greenenergyprojects/electro-vehicle-wallbox-station/evws1/kicad/dist/evws1_image-bottom.jpg

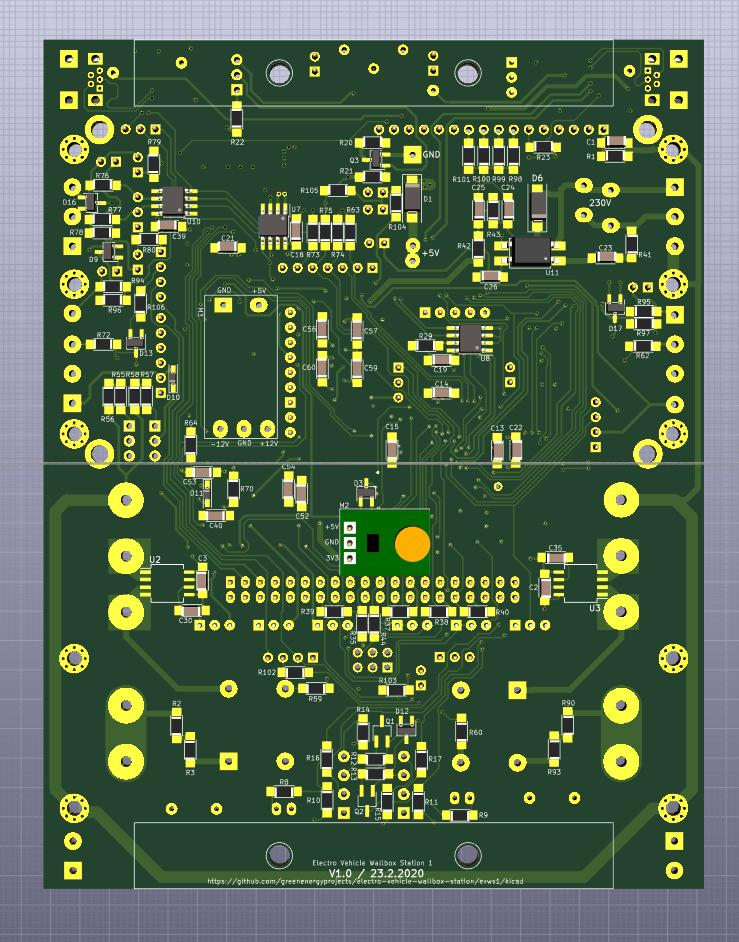
evws1/kicad/dist/evws1_image-bottom.jpg
