greenenergyprojects/electro-vehicle-wallbox-station/evws1/kicad/dist/evws1_image-top.jpg

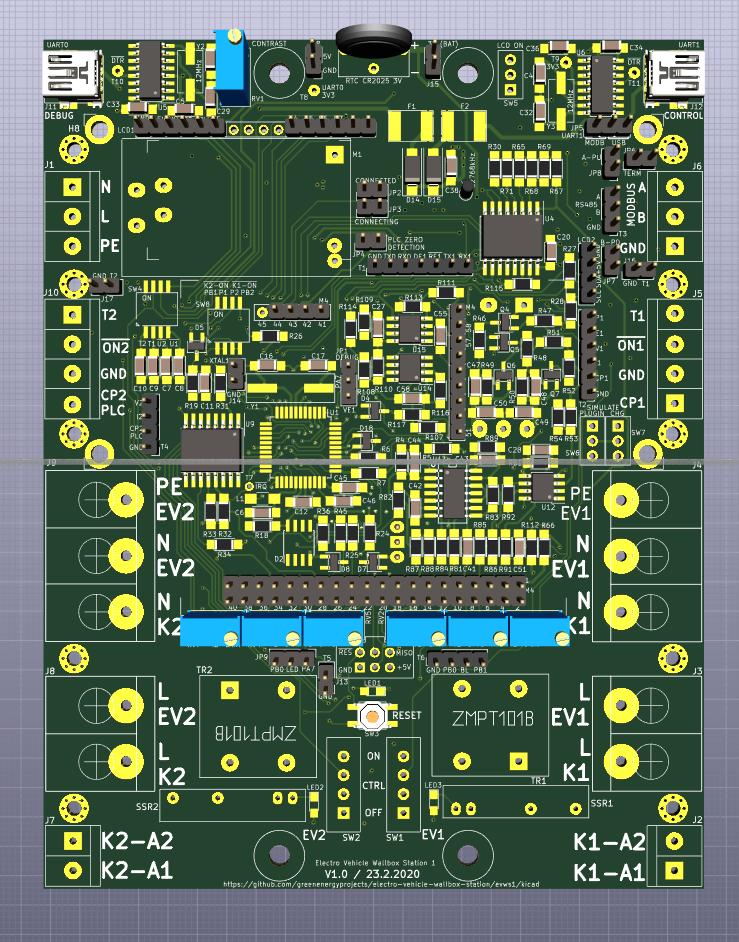
evws1/kicad/dist/evws1_image-top.jpg
