greenenergyprojects/electro-vehicle-wallbox-station/README.md

# electro-vehicle-wallbox-station
Electro Vehicle Wallbox, Mode 3 / Typ 2 (230V/AC/20A)
