greenenergyprojects/electro-vehicle-wallbox-station/evws1/kicad/dist/README.md

# Manufacturing report

## Gerber Files

See [https://support.jlcpcb.com/article/44-how-to-export-kicad-pcb-to-gerber-files](https://support.jlcpcb.com/article/44-how-to-export-kicad-pcb-to-gerber-files)

## Manufacturing details

* Tapeout: 23.2.2020
  [https://jlcpcb.com/client/index.html#/order](https://jlcpcb.com/client/index.html#/order)
  Order Number: Y11-2360571A (5 pcs, €62,95 EUR)

# Bugs / Improvements

Mechanical Drawings from Layer NP to PHT(PLATING Through Hole) (email request from support@jlcpcb.com on 2018-09-21)

| Reference | Description |
| --- | --- |
