greenenergyprojects/electro-vehicle-wallbox-station/evws1/kicad/dist/evws1_bom.ods

Source: | /work/sx/gep/electro-vehicle-wallbox-station/evws1/kicad/evws1.sch
Date: | So 23 Feb 2020 16:09:32 CET
Tool: | Eeschema 5.0.2-bee76a0~70~ubuntu18.04.1
Component Count: | 302
Ref | Value | Footprint | Datasheet | Manufacturer | Vendor
BT1 | 3V | Project:knob-battery-holder-vertical-tht | ~
C1 | 1n | Project:c-1206-hand-soldering | ~
C2 | 100n | Project:c-1206-hand-soldering | ~
C3 | 100n | Project:c-1206-hand-soldering | ~
C4 | 22p | Project:c-1206-hand-soldering | ~
C5 | 100n | Project:c-1206-hand-soldering | ~
C6 | 100n | Project:c-1206-hand-soldering | ~
C7 | 100n | Project:c-1206-hand-soldering | ~
C8 | 100n | Project:c-1206-hand-soldering | ~
C9 | 100n | Project:c-1206-hand-soldering | ~
C10 | 100n | Project:c-1206-hand-soldering | ~
C11 | 1n | Project:c-1206-hand-soldering | ~
C12 | 100n | Project:c-1206-hand-soldering | ~
C13 | 100n | Project:c-1206-hand-soldering | ~
C14 | 100n | Project:c-1206-hand-soldering | ~
C15 | 100n | Project:c-1206-hand-soldering | ~
C16 | 22p | Project:c-1206-hand-soldering | ~
C17 | 22p | Project:c-1206-hand-soldering | ~
C18 | 100n | Project:c-1206-hand-soldering | ~
C19 | 100n | Project:c-1206-hand-soldering | ~
C20 | 100n | Project:c-1206-hand-soldering | ~
C21 | 100n | Project:c-1206-hand-soldering | ~
C22 | 100n | Project:c-1206-hand-soldering | ~
C23 | 2.2n | Project:c-1206-hand-soldering | ~
C24 | 220n | Project:c-1206-hand-soldering | ~
C25 | 1u | Project:c-1206-hand-soldering | ~
C26 | 1n | Project:c-1206-hand-soldering | ~
C27 | 1pF | Project:c-1206-hand-soldering | ~
C28 | 1u | Project:c-1206-hand-soldering
C29 | 22p | Project:c-1206-hand-soldering | ~
C30 | 1n | Project:c-1206-hand-soldering | ~
C31 | 22p | Project:c-1206-hand-soldering | ~
C32 | 22p | Project:c-1206-hand-soldering | ~
C33 | 100n | Project:c-1206-hand-soldering | ~
C34 | 100n | Project:c-1206-hand-soldering | ~
C35 | 1n | Project:c-1206-hand-soldering | ~
C36 | 100n | Project:c-1206-hand-soldering | ~
C38 | 100n | Project:c-1206-hand-soldering | ~
C39 | 100n | Project:c-1206-hand-soldering | ~
C40 | 100n | Project:c-1206-hand-soldering | ~
C41 | 10n | Project:c-1206-hand-soldering | ~
C42 | 10n | Project:c-1206-hand-soldering | ~
C43 | 10n | Project:c-1206-hand-soldering | ~
C44 | 10n | Project:c-1206-hand-soldering | ~
C45 | 1n | Project:c-1206-hand-soldering | ~
C46 | 1n | Project:c-1206-hand-soldering | ~
C47 | 1n | Project:c-1206-hand-soldering | ~
C48 | 1n | Project:c-1206-hand-soldering | ~
C49 | 1u | Project:c-1206-hand-soldering | ~
C50 | 1u | Project:c-1206-hand-soldering | ~
C51 | 100n | Project:c-1206-hand-soldering | ~
C52 | 100n | Project:c-1206-hand-soldering | ~
C53 | 100n | Project:c-1206-hand-soldering | ~
C54 | 100n | Project:c-1206-hand-soldering | ~
C55 | 1pF | Project:c-1206-hand-soldering | ~
C56 | 100n | Project:c-1206-hand-soldering | ~
C57 | 100n | Project:c-1206-hand-soldering | ~
C58 | 1u | Project:c-1206-hand-soldering | ~
C59 | 100n | Project:c-1206-hand-soldering | ~
C60 | 100n | Project:c-1206-hand-soldering | ~
D1 | SS34 | Project:sma_hand-soldering | ~
D2 | LM285M-2.5 | Project:SOIC-8_3.9x4.9mm_Pitch1.27mm_Handsolded
D3 | BAT54S | Project:sot-23_hand-soldering
D4 | BAT54S | Project:sot-23_hand-soldering
D5 | BAT54S | Project:sot-23_hand-soldering
D6 | 1N4007 | Project:sma_hand-soldering | ~
D7 | BAT54S | Project:sot-23_hand-soldering
D8 | BAT54S | Project:sot-23_hand-soldering
D9 | BAT54S | Project:sot-23_hand-soldering
D10 | B5819WS | Project:sod-323_hand-soldering
D11 | B5819WS | Project:sod-323_hand-soldering
D12 | BAT54S | Project:sot-23_hand-soldering
D13 | BAT54S | Project:sot-23_hand-soldering
D14 | SS34 | Project:sma_hand-soldering
D15 | SS34 | Project:sma_hand-soldering
D16 | SM712 | Project:sot-23_hand-soldering
D17 | BAT54S | Project:sot-23_hand-soldering
D18 | BAT54S | Project:sot-23_hand-soldering
F1 | MF-SMDF050-2 | Project:mf-smdf | ~
F2 | MF-SMDF050-2 | Project:mf-smdf | ~
H1 | DIN-Rail-Adapter-DRG02 | Project:DIN-RAIL-ADAPTER-DRG-02-ebay-254055322883 | ~
H2 | DIN-Rail-Adapter-DRG02 | Project:DIN-RAIL-ADAPTER-DRG-02-ebay-254055322883 | ~
H3 | MountingHole_Pad | Mounting_Holes:MountingHole_2.5mm_Pad_Via | ~
H4 | MountingHole_Pad | Mounting_Holes:MountingHole_2.5mm_Pad_Via | ~
H5 | MountingHole_Pad | Mounting_Holes:MountingHole_2.5mm_Pad_Via | ~
H6 | MountingHole_Pad | Mounting_Holes:MountingHole_2.5mm_Pad_Via | ~
H7 | MountingHole_Pad | Mounting_Holes:MountingHole_2.5mm_Pad_Via | ~
H8 | MountingHole_Pad | Mounting_Holes:MountingHole_2.5mm_Pad_Via | ~
H9 | MountingHole_Pad | Mounting_Holes:MountingHole_2.5mm_Pad_Via | ~
H10 | MountingHole_Pad | Mounting_Holes:MountingHole_2.5mm_Pad_Via | ~
H11 | MountingHole_Pad | Mounting_Holes:MountingHole_2.5mm_Pad_Via | ~
H12 | MountingHole_Pad | Mounting_Holes:MountingHole_2.5mm_Pad_Via | ~
J1 | Screw_Terminal_01x03 | Project:Terminalblock-5mm-3P | ~
J2 | Screw_Terminal_01x02 | Project:Terminalblock-5mm-2P | ~
J3 | HB9500-2P | Project:HB9500-2P
J4 | HB9500-3P | Project:HB9500-3P
J5 | Screw_Terminal_01x04 | Project:Terminalblock-5mm-4P | ~
J6 | Screw_Terminal_01x03 | Project:Terminalblock-5mm-3P | ~
J7 | Screw_Terminal_01x02 | Project:Terminalblock-5mm-2P | ~
J8 | HB9500-2P | Project:HB9500-2P
J9 | HB9500-3P | Project:HB9500-3P
J10 | Screw_Terminal_01x04 | Project:Terminalblock-5mm-4P | ~
J11 | USB 2.0 Mini | Project:usb-mini-tht
J12 | USB 2.0 Mini | Project:usb-mini-tht
J13 | atmega-isp-6 | Project:AVR-ISP-6
J14 | header | Project:idc-header-1x02-p2.54mm-vertical | ~
J15 | header | Project:idc-header-1x02-p2.54mm-vertical | ~
J16 | header | Project:idc-header-1x02-p2.54mm-vertical | ~
J17 | header | Project:idc-header-1x02-p2.54mm-vertical | ~
J18 | header | Project:idc-header-1x02-p2.54mm-vertical | ~
JP1 | Jumper_3_Bridged12 | Project:idc-header-1x03-p2.54mm-vertical | ~
JP2 | header | Project:idc-header-1x02-p2.54mm-vertical | ~
JP3 | header | Project:idc-header-1x02-p2.54mm-vertical | ~
JP4 | Jumper_NO_Small | Project:idc-header-1x02-p2.54mm-vertical | ~
JP5 | Jumper | Project:idc-header-1x03-p2.54mm-vertical | ~
JP6 | header | Project:idc-header-1x02-p2.54mm-vertical | ~
JP7 | header | Project:idc-header-1x02-p2.54mm-vertical | ~
JP8 | header | Project:idc-header-1x02-p2.54mm-vertical | ~
JP9 | header | Project:idc-header-1x03-p2.54mm-vertical | ~
L1 | 10uH | Inductors_SMD:L_1206_HandSoldering | ~
LCD1 | lcd-4x20-5v-backlight-4bit | Project:lcd-4x20-5v-backlight-4bit
LCD2 | header | Project:idc-header-1x04-p2.54mm-vertical | ~
LED1 | LED | LEDs:LED_0805_HandSoldering | ~
LED2 | LED | LEDs:LED_0805_HandSoldering | ~
LED3 | LED | LEDs:LED_0805_HandSoldering | ~
M1 | HLK-PM01 | Project:HLK-PM01-5M05
M2 | dc-dc-buck-converter-5v-to-3.3v-2a | Project:dc-dc-buck-converter-5v-to-3.3v-2a
M3 | dc-dc-converter-5v-to-p12v-m12v | Project:dc-dc-converter-5v-to-p12v-m12v
M4 | rpi-ev-plc-adapter-v1.0 | Project:rpi-ev-plc-adapter-v1.0
Q1 | AO3401 | TO_SOT_Packages_SMD:TSOT-23_HandSoldering | ~
Q2 | AO3401 | TO_SOT_Packages_SMD:TSOT-23_HandSoldering | ~
Q3 | AO3400 | Project:sot-23_hand-soldering
Q4 | AO3400 | Project:sot-23_hand-soldering
Q5 | AO3401 | Project:sot-23_hand-soldering | ~
Q6 | AO3401 | Project:sot-23_hand-soldering | ~
Q7 | AO3400 | Project:sot-23_hand-soldering
R1 | 0R | Project:r-1206-hand-soldering | ~
R2 | 390K | Project:r-1206-hand-soldering | ~
R3 | 390K | Project:r-1206-hand-soldering | ~
R4 | 10K | Project:r-1206-hand-soldering | ~
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
R98 | 47K | Project:r-1206-hand-soldering | ~
R99 | 47K | Project:r-1206-hand-soldering | ~
R100 | 47K | Project:r-1206-hand-soldering | ~
R101 | 47K | Project:r-1206-hand-soldering | ~
R102 | 220R | Project:r-1206-hand-soldering | ~
R103 | 1K | Project:r-1206-hand-soldering | ~
R104 | 270R | Project:r-1206-hand-soldering | ~
R105 | 560R | Project:r-1206-hand-soldering | ~
R106 | 0R | Project:r-1206-hand-soldering | ~
R107 | 1K | Project:r-1206-hand-soldering | ~
R108 | 10K | Project:r-1206-hand-soldering | ~
R109 | 0R | Project:r-1206-hand-soldering | ~
R110 | 0R | Project:r-1206-hand-soldering | ~
R111 | 0R | Project:r-1206-hand-soldering | ~
R112 | 0R | Project:r-1206-hand-soldering | ~
R113 | 10K | Project:r-1206-hand-soldering | ~
R114 | 10K | Project:r-1206-hand-soldering | ~
R115 | 10K | Project:r-1206-hand-soldering | ~
R116 | 470K | Project:r-1206-hand-soldering | ~
R117 | 1K | Project:r-1206-hand-soldering | ~
RV1 | 10K | Project:trimmer-tht-3296 | ~
RV2 | 100R | Project:trimmer-tht-3296 | ~
RV3 | 1K | Project:trimmer-tht-3296 | ~
RV4 | 100R | Project:trimmer-tht-3296 | ~
RV5 | 1K | Project:trimmer-tht-3296 | ~
RV6 | 1K | Project:trimmer-tht-3296 | ~
RV7 | 1K | Project:trimmer-tht-3296 | ~
SSR1 | G3MB-202P | Project:SSR_Omron_G3MB-202P
SSR2 | G3MB-202P | Project:SSR_Omron_G3MB-202P
SW1 | SW_SS13F06-G5 | Project:Switch-3pos-SS13F06-G5
SW2 | SW_SS13F06-G5 | Project:Switch-3pos-SS13F06-G5
SW3 | SW_Push | Project:push-button-smd-4.5x4.5mm-black
SW4 | dip-switch-4x2pos-smd-1.27mm | Project:dip-switch-4x2pos-smd-1.27mm
SW5 | SS-12D00G3 | Project:switch_ss-12d00g3
SW6 | SS-12D00G3 | Project:switch_ss-12d00g3
SW7 | SS-12D00G3 | Project:switch_ss-12d00g3
SW8 | dip-switch-4x2pos-smd-1.27mm | Project:dip-switch-4x2pos-smd-1.27mm
T1 | header | Project:idc-header-1x07-p2.54mm-vertical | ~
T2 | header | Project:idc-header-1x06-p2.54mm-vertical | ~
T3 | header | Project:idc-header-1x03-p2.54mm-vertical | ~
T4 | header | Project:idc-header-1x04-p2.54mm-vertical | ~
T5 | header | Project:idc-header-1x02-p2.54mm-vertical | ~
T6 | header | Project:idc-header-1x04-p2.54mm-vertical | ~
T7 | TestPoint | Measurement_Points:Measurement_Point_Round-TH_Small | ~
T8 | TestPoint | Wire_Pads:SolderWirePad_single_0-8mmDrill | ~
T9 | TestPoint | Wire_Pads:SolderWirePad_single_0-8mmDrill | ~
T10 | TestPoint | Wire_Pads:SolderWirePad_single_0-8mmDrill | ~
T11 | TestPoint | Wire_Pads:SolderWirePad_single_0-8mmDrill | ~
TR1 | ZMPT101B | Project:Transformer-zmpt101b_ebay-121438904988
TR2 | ZMPT101B | Project:Transformer-zmpt101b_ebay-121438904988
U1 | atmega324p-20au | Project:TQFP-44_10x10mm_Pitch0.8mm
U2 | ACS712-30 | Project:ACS712
U3 | ACS712-30 | Project:ACS712
U4 | PCF8591 | Project:soic-16w_hand-soldering
U5 | ch340g | Project:soic-16_hand-soldering
U6 | ch340g | Project:soic-16_hand-soldering
U7 | DS1307ZN | Project:soic-8_hand-soldering
U8 | 24LC512 | Project:soic-8_hand-soldering
U9 | PCF8574 | Project:soic-16w_hand-soldering
U10 | max485esa | Project:soic-8_hand-soldering
U11 | PC817C | Project:sop-4-pc817
U12 | LM258 | Project:soic-8_hand-soldering
U13 | LM224 | Project:soic-14_hand-soldering
U14 | LM258 | Project:soic-8_hand-soldering
U15 | AD633AR | Project:soic-8_hand-soldering
Y1 | 20MHz | Project:hc49s-smd | ~
Y2 | 12MHz | Project:Oscillator-SMD-M49S | ~
Y3 | 12MHz | Project:Oscillator-SMD-M49S | ~
Y4 | 32768kHz | Project:crystal-32.768khz-2x6mm-tht-vertical | ~
