greenenergyprojects/electro-vehicle-wallbox-station/evws1/kicad/dist/evws1_schematic-bw.pdf

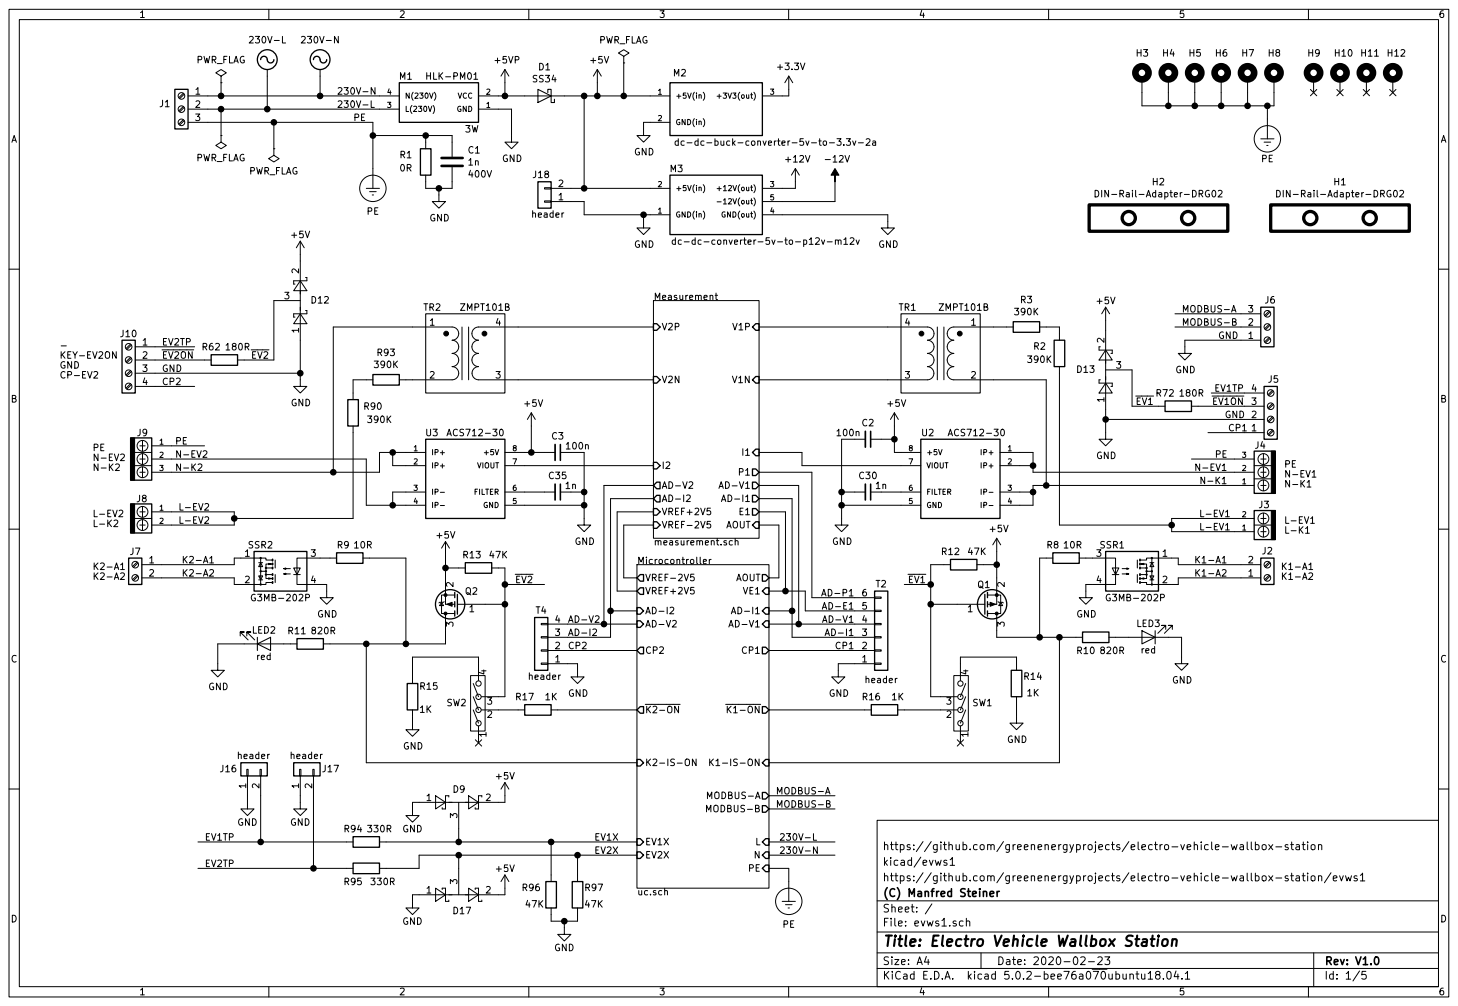
[picture p3: page 1]

2 | 230V-L
3 | PE

dc-dc-buck-converter-5v-to-3.3v-2a GND

https://github.com/greenenergyprojects/electro-vehicle-wallbox-station
kicad/evws1
https://github.com/greenenergyprojects/electro-vehicle-wallbox-station/evws1
File: evws1.sch Sheet: / (C) Manfred Steiner

Id: 1/5 Title: Electro Vehicle Wallbox Station

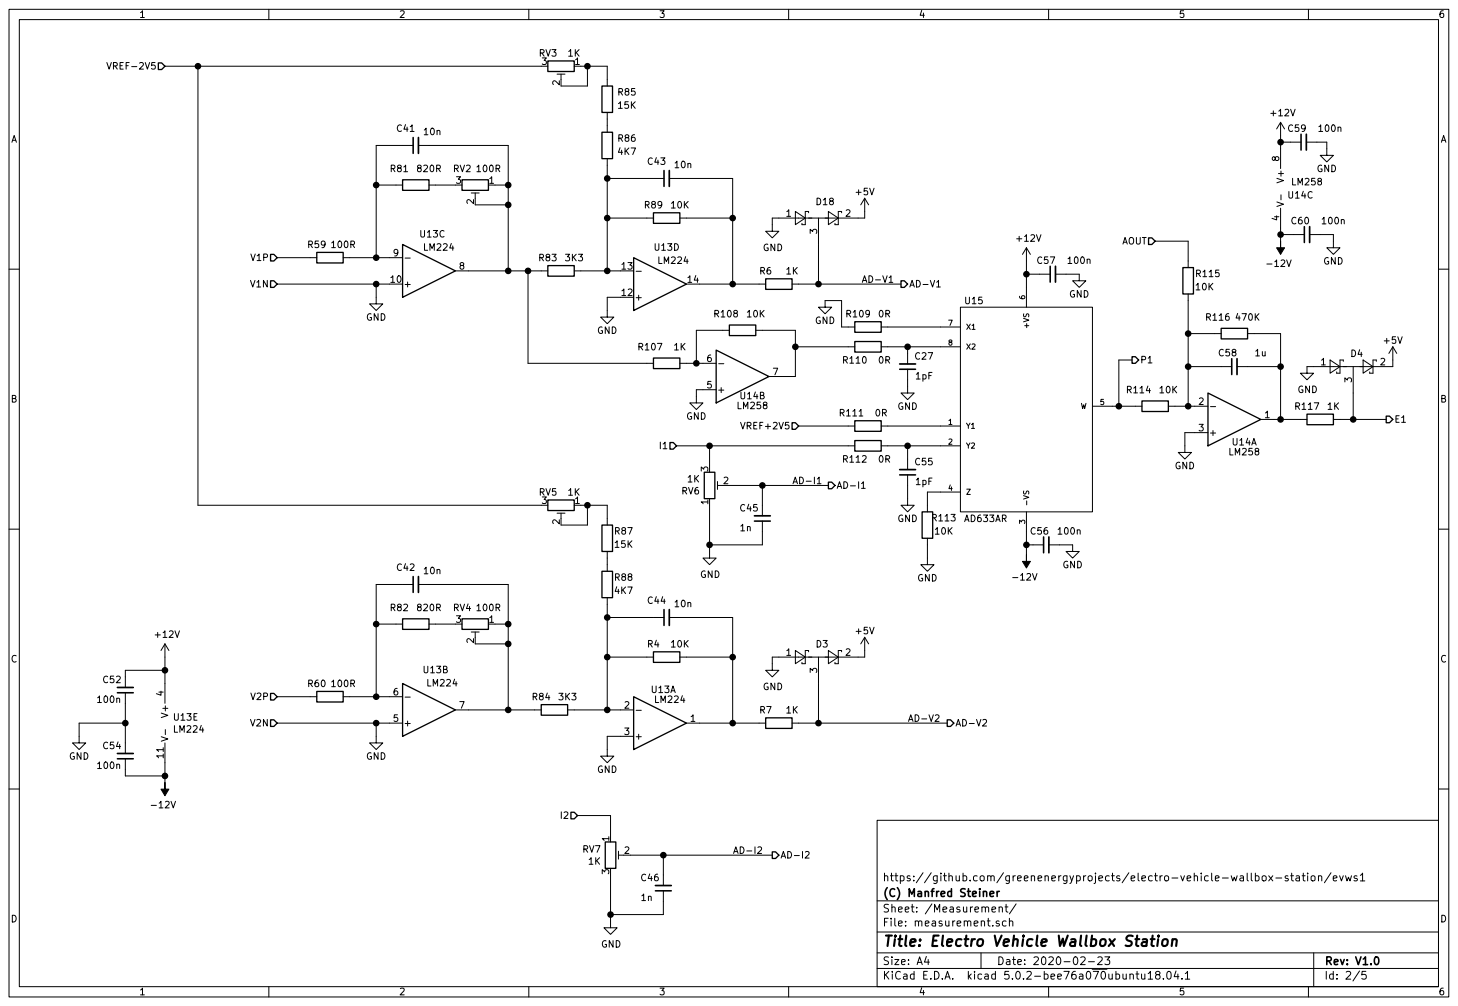
[picture p4: page 2]

https://github.com/greenenergyprojects/electro-vehicle-wallbox-station/evws1
File: measurement.sch Sheet: /Measurement/ (C) Manfred Steiner

Id: 2/5 Title: Electro Vehicle Wallbox Station

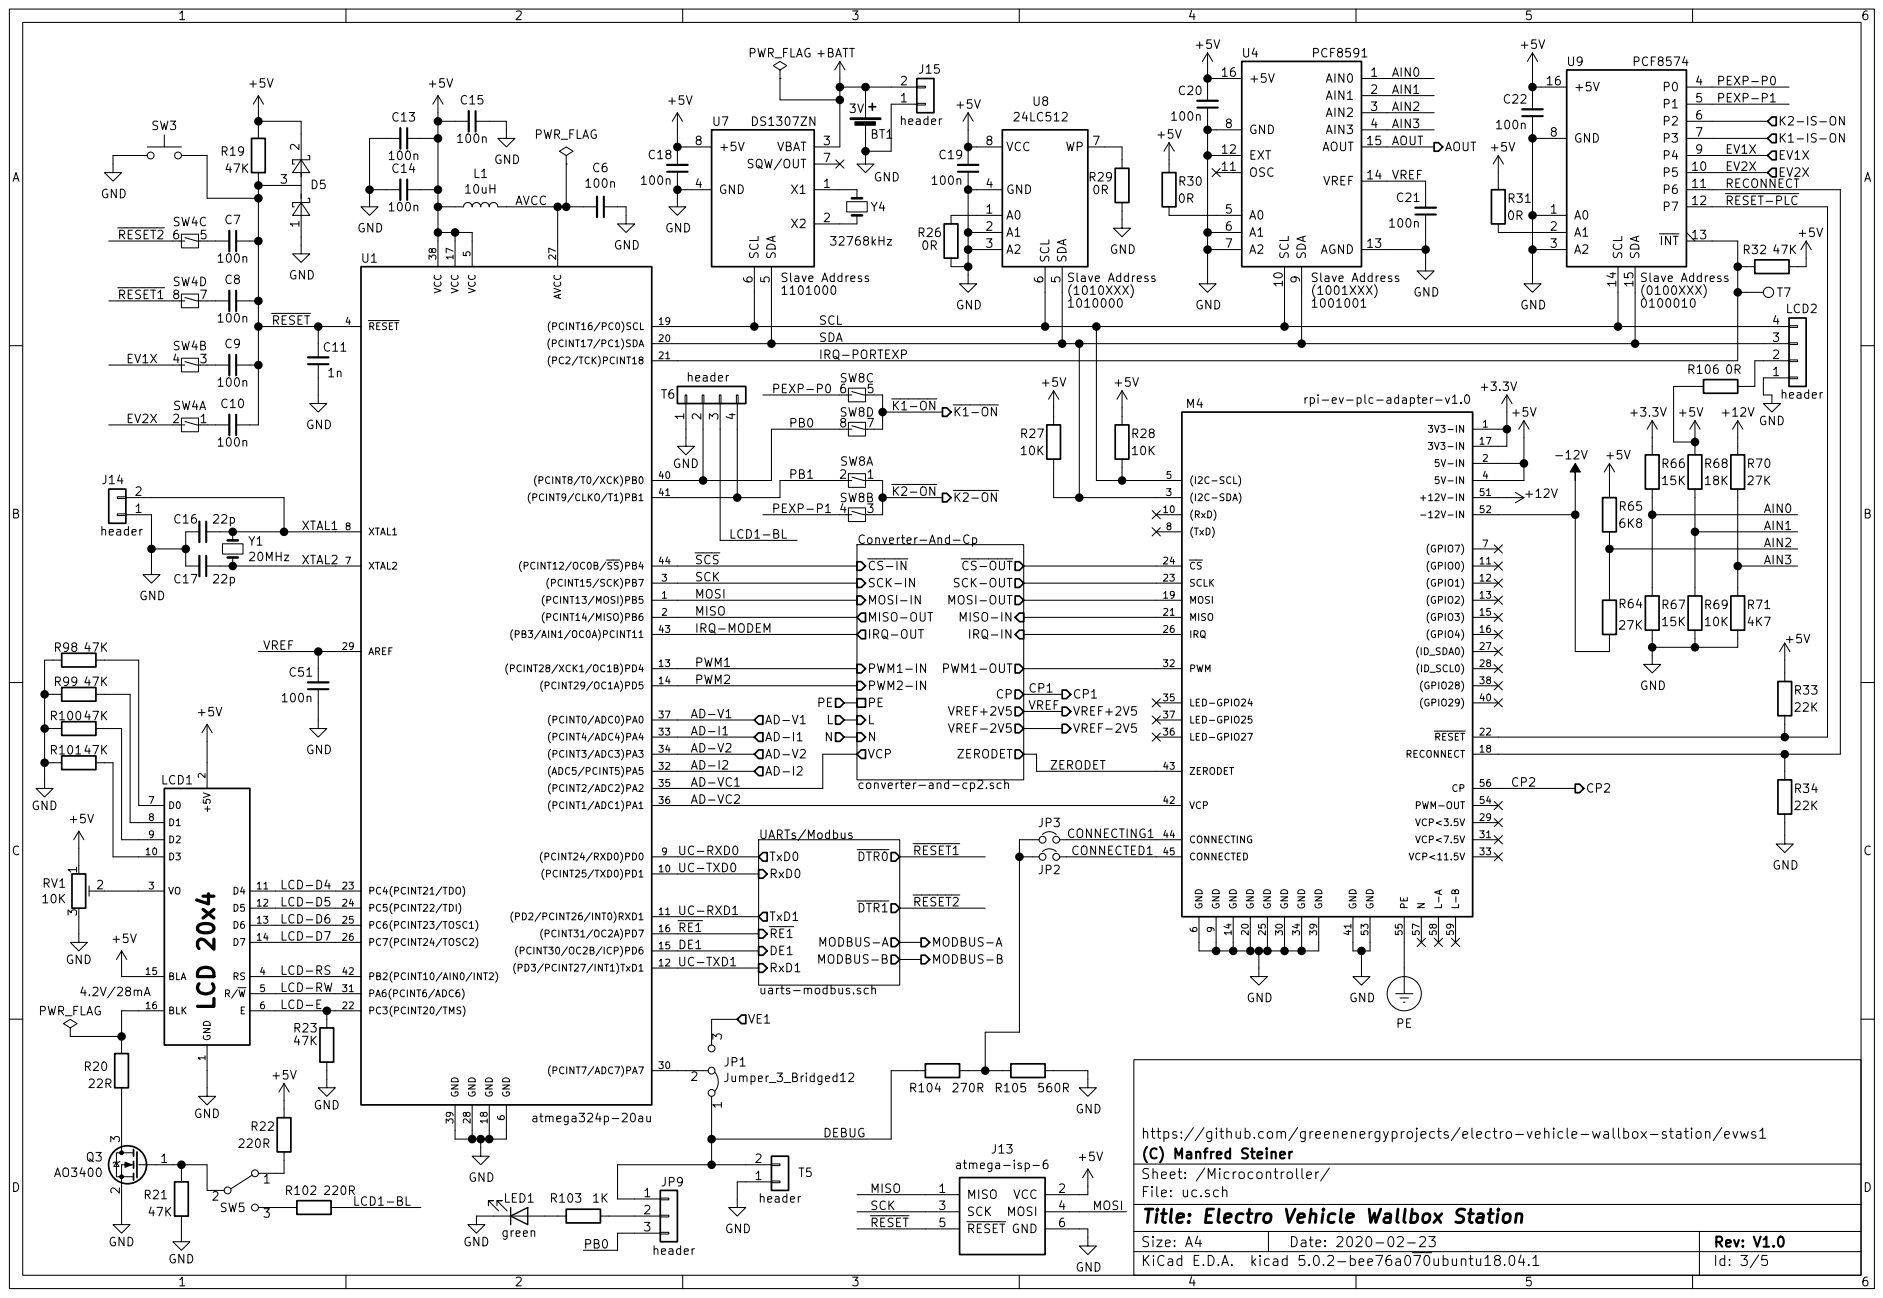
[picture p5: page 3]

6 SQW/OUT 7 +5V 8 U7 DS1307ZN
1n GND GND LCD 20x4 GND

IRQ-PORTEXP | 2

9 M4 rpi-ev-plc-adapter-v1.0

CS-OUT SCK-OUT MOSI-OUT MISO-OUT

converter-and-cp2.sch PE

https://github.com/greenenergyprojects/electro-vehicle-wallbox-station/evws1
File: uc.sch Sheet: /Microcontroller/ (C) Manfred Steiner
GNDMOSI +5V

Id: 3/5 Title: Electro Vehicle Wallbox Station

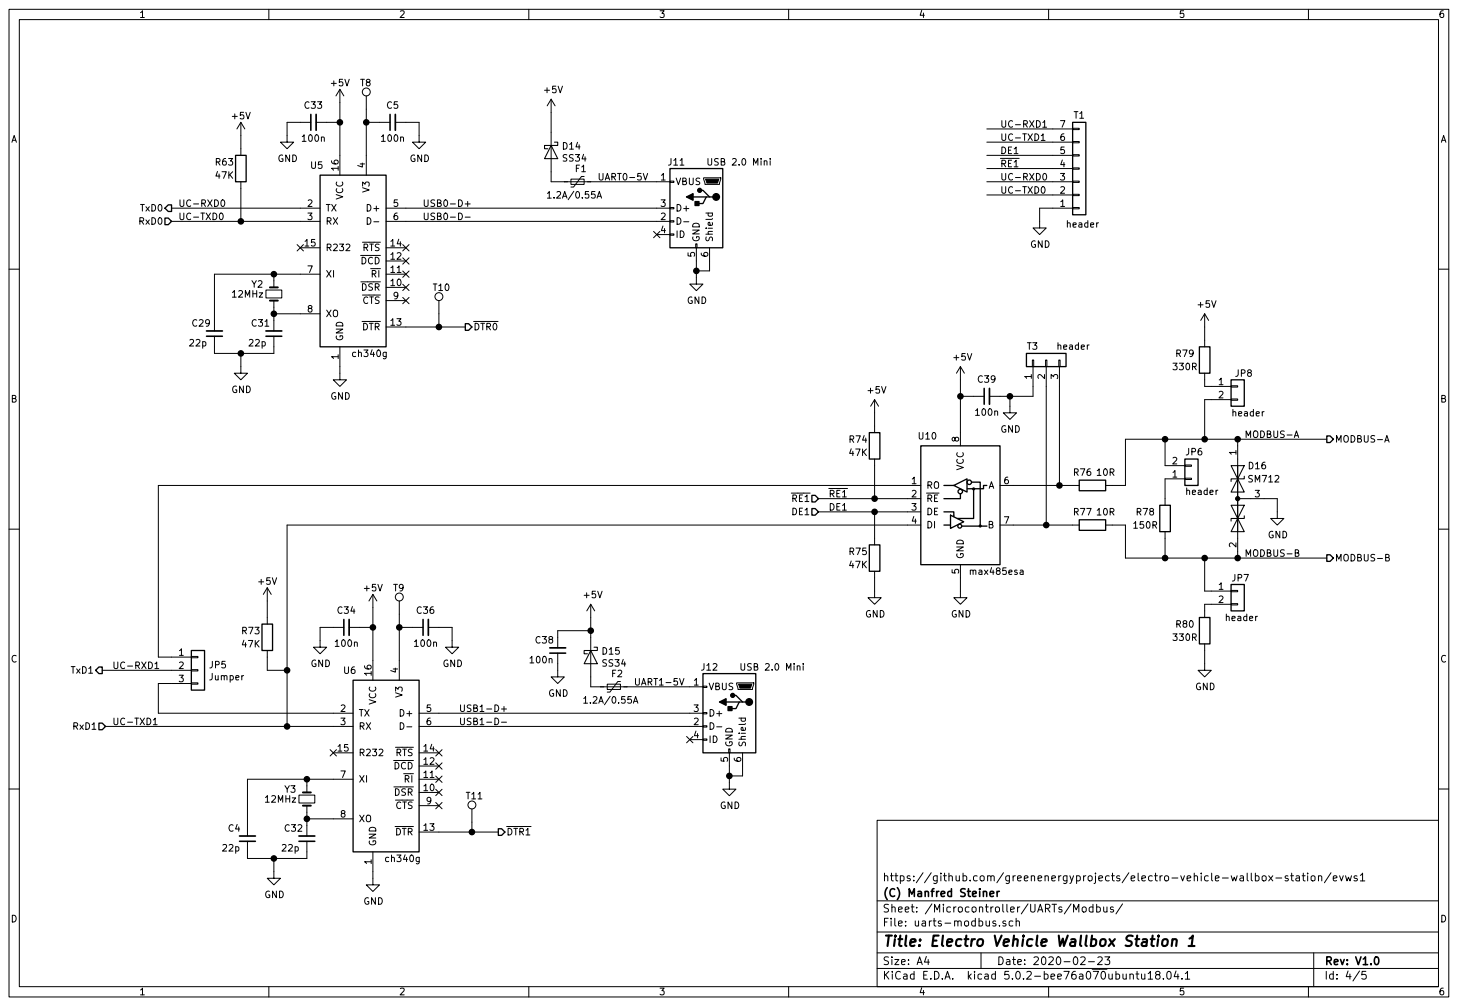
[picture p6: page 4]

+5V UC-RXD0 UC-TXD0 UC-RXD1 UC-TXD1

1 DSR 10 RI 11 DCD 12 DTR 13 RTS 14 R232 15 VCC 16 TX 2 RX 3 V3

File: uarts-modbus.sch Sheet: /Microcontroller/UARTs/Modbus/ (C) Manfred Steiner

Id: 4/5 Title: Electro Vehicle Wallbox Station 1

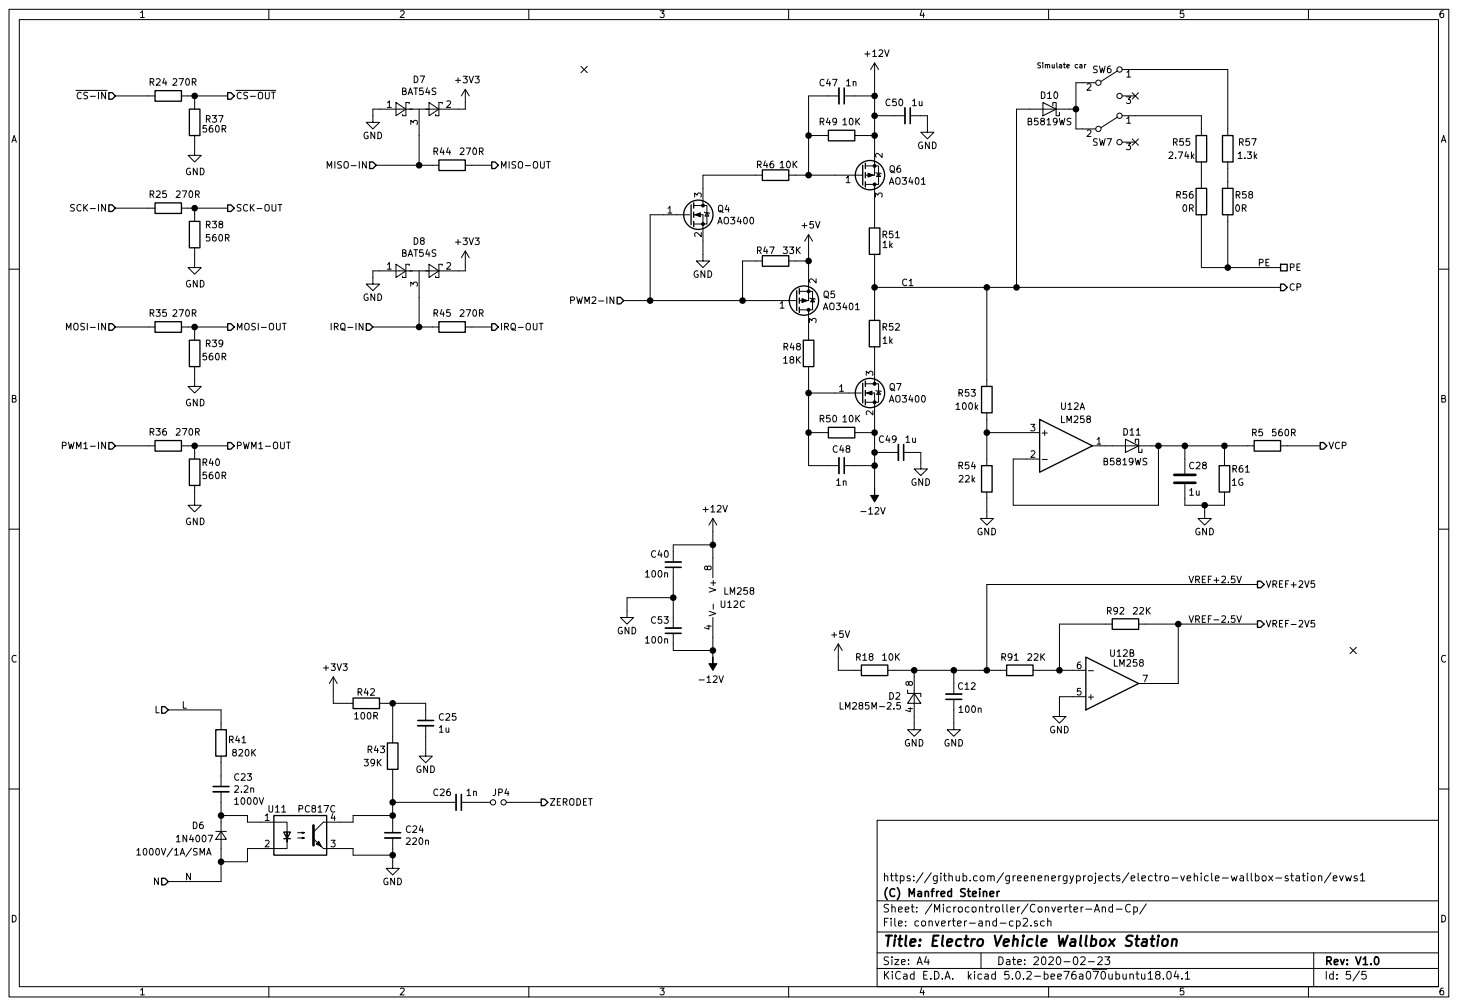
[picture p7: page 5]

https://github.com/greenenergyprojects/electro-vehicle-wallbox-station/evws1
(C) Manfred Steiner
Sheet: /Microcontroller/Converter-And-Cp/
File: converter-and-cp2.sch
Id: 5/5 Title: Electro Vehicle Wallbox Station
