greenenergyprojects/electro-vehicle-wallbox-station/evws1/kicad/evws1.kicad_pcb

## KiCad design evws1/kicad/evws1.kicad_pcb (2020-02-23)

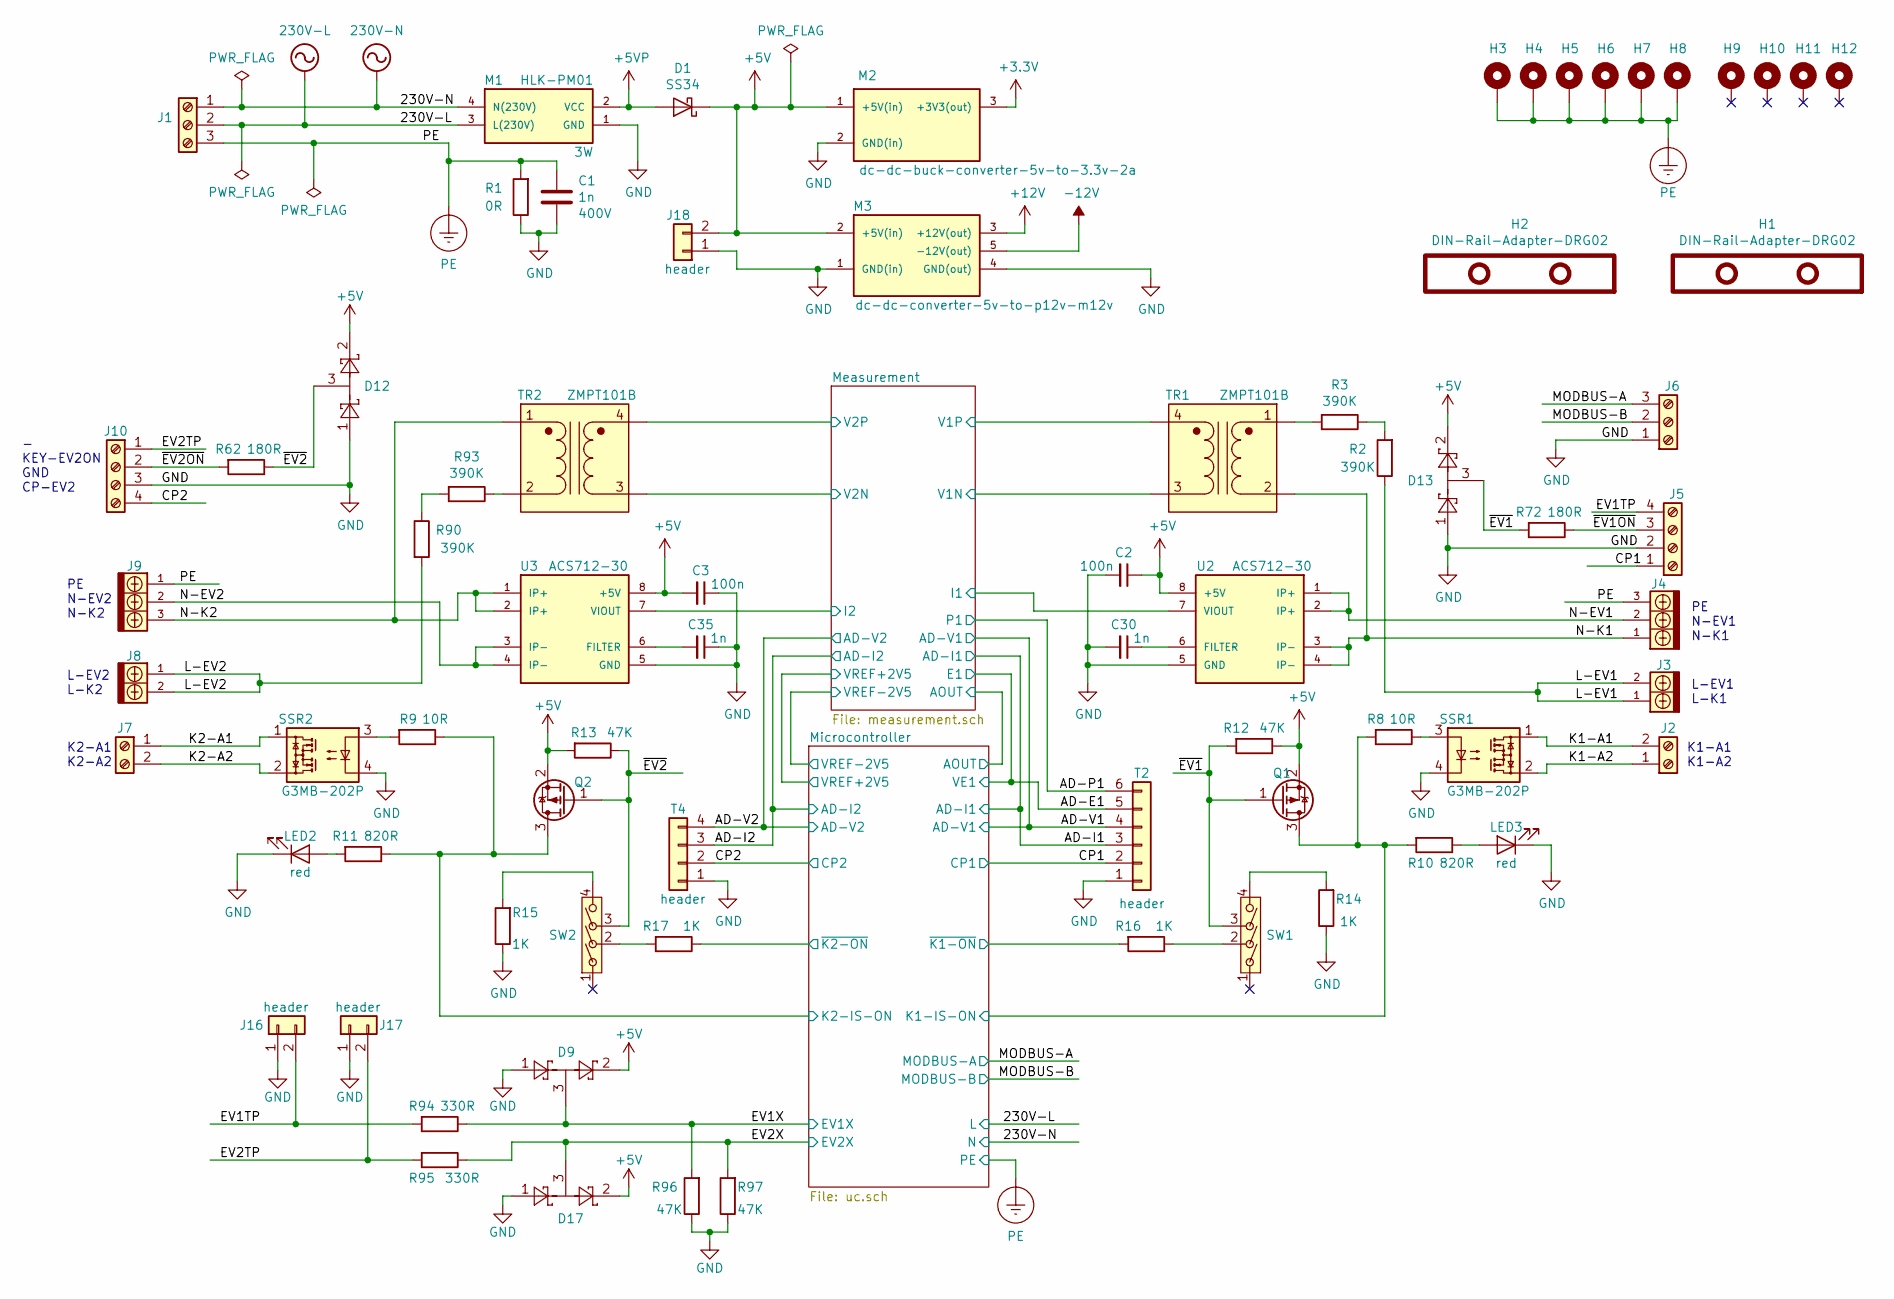
[picture p25: schematic evws1.sch, Electro Vehicle Wallbox Station]

Parts:
C1: 1n; c-1206-hand-soldering; Voltage 400V
C2, C3: 100n; c-1206-hand-soldering
C30, C35: 1n; c-1206-hand-soldering
D1: SS34; sma_hand-soldering
D9, D12, D13, D17: BAT54S; sot-23_hand-soldering
H1, H2: DIN-Rail-Adapter-DRG02; DIN-RAIL-ADAPTER-DRG-02-ebay-254055322883
H3, H4, H5, H6, H7, H8, H9, H10, H11, H12: MountingHole_Pad; MountingHole_2.5mm_Pad_Via
J1, J6: Screw_Terminal_01x03; Terminalblock-5mm-3P
J2, J7: Screw_Terminal_01x02; Terminalblock-5mm-2P
J3, J8: HB9500-2P
J4, J9: HB9500-3P
J5, J10: Screw_Terminal_01x04; Terminalblock-5mm-4P
J16, J17, J18: header; idc-header-1x02-p2.54mm-vertical
LED2, LED3: LED; LED_0805_HandSoldering
M1: HLK-PM01; HLK-PM01-5M05
M2: dc-dc-buck-converter-5v-to-3.3v-2a
M3: dc-dc-converter-5v-to-p12v-m12v
Q1, Q2: AO3401; TSOT-23_HandSoldering
R1: 0R; r-1206-hand-soldering
R2, R3, R90, R93: 390K; r-1206-hand-soldering
R8, R9: 10R; r-1206-hand-soldering
R10, R11: 820R; r-1206-hand-soldering
R12, R13, R96, R97: 47K; r-1206-hand-soldering
R14, R15, R16, R17: 1K; r-1206-hand-soldering
R62, R72: 180R; r-1206-hand-soldering
R94, R95: 330R; r-1206-hand-soldering
SSR1, SSR2: G3MB-202P; SSR_Omron_G3MB-202P
SW1, SW2: SW_SS13F06-G5; Switch-3pos-SS13F06-G5
T2: header; idc-header-1x06-p2.54mm-vertical
T4: header; idc-header-1x04-p2.54mm-vertical
TR1, TR2: ZMPT101B; Transformer-zmpt101b_ebay-121438904988
U2, U3: ACS712-30; ACS712

Connections:
230V-L: J1.2, M1.3 (L(230V)); also elsewhere on the board
230V-N: J1.1, M1.4 (N(230V)); also elsewhere on the board
+5V: C2.1, C3.2, D1.1 (K), D9.2, D12.2, D13.2, D17.2, J18.2, M2.1 (+5V(in)), M3.2 (+5V(in)), Q1.2 (S), Q2.2 (S), R12.1, R13.2, U2.8 (+5V), U3.8 (+5V); also elsewhere on the board
+5VP: D1.2 (A), M1.2 (VCC)
+12V: M3.3 (+12V(out)); also elsewhere on the board
-12V: M3.5 (-12V(out)); also elsewhere on the board
/AD-E1: T2.5; also elsewhere on the board
/AD-I1: T2.3; also elsewhere on the board
/AD-I2: T4.3; also elsewhere on the board
/AD-P1: T2.6; also elsewhere on the board
/AD-V1: T2.4; also elsewhere on the board
/AD-V2: T4.4; also elsewhere on the board
/CP1: J5.1, T2.2; also elsewhere on the board
/CP2: J10.4, T4.2; also elsewhere on the board
/EV1TP: J5.4, J16.2, R94.2
/EV1X: D9.3, R94.1, R96.2; also elsewhere on the board
/EV2TP: J10.1, J17.2, R95.2
/EV2X: D17.3, R95.1, R97.2; also elsewhere on the board
/K1-A1: J2.2, SSR1.1 (AC)
/K1-A2: J2.1, SSR1.2 (AC)
/K2-A1: J7.1, SSR2.1 (AC)
/K2-A2: J7.2, SSR2.2 (AC)
/L-EV1: J3.1, J3.2, R2.1
/L-EV2: J8.1, J8.2, R90.2
/MODBUS-A: J6.3; also elsewhere on the board
/MODBUS-B: J6.2; also elsewhere on the board
/Measurement/I1: U2.7 (VIOUT); also elsewhere on the board
/Measurement/I2: U3.7 (VIOUT); also elsewhere on the board
/Measurement/V1P: TR1.4 (SB); also elsewhere on the board
/Measurement/V2P: TR2.4 (SB); also elsewhere on the board
/Microcontroller/K1-IS-ON: Q1.3 (D), R8.2, R10.2; also elsewhere on the board
/Microcontroller/K2-IS-ON: Q2.3 (D), R9.1, R11.1; also elsewhere on the board
/Microcontroller/~K1-ON: R16.2; also elsewhere on the board
/Microcontroller/~K2-ON: R17.1; also elsewhere on the board
/N-EV1: J4.2, U2.1 (IP+), U2.2 (IP+)
/N-EV2: J9.2, U3.3 (IP-), U3.4 (IP-)
/N-K1: J4.1, TR1.2 (AB), U2.3 (IP-), U2.4 (IP-)
/N-K2: J9.3, TR2.1 (AA), U3.1 (IP+), U3.2 (IP+)
/~EV1: D13.3, Q1.1 (G), R12.2, R72.2, SW1.3
/~EV1ON: J5.3, R72.1
/~EV2: D12.3, Q2.1 (G), R13.1, R62.1, SW2.3
/~EV2ON: J10.2, R62.2
GND: C1.2, C2.2, C3.1, C30.2, C35.1, D9.1, D12.1, D13.1, D17.1, J5.2, J6.1, J10.3, J16.1, J17.1, J18.1, LED2.1 (K), LED3.1 (K), M1.1 (GND), M2.2 (GND(in)), M3.1 (GND(in)), M3.4 (GND(out)), R1.1, R14.1, R15.1, R96.1, R97.1, SSR1.4 (-), SSR2.4 (-), T2.1, T4.1, TR1.3 (SA), TR2.3 (SA), U2.5 (GND), U3.5 (GND); also elsewhere on the board
unnamed: C30.1, U2.6 (FILTER)
unnamed: C35.2, U3.6 (FILTER)
unnamed: LED2.2 (A), R11.2
unnamed: LED3.2 (A), R10.1
unnamed: R2.2, R3.1
unnamed: R3.2, TR1.1 (AA)
unnamed: R8.1, SSR1.3 (+)
unnamed: R9.2, SSR2.3 (+)
unnamed: R14.2, SW1.4
unnamed: R15.2, SW2.4
unnamed: R16.1, SW1.2
unnamed: R17.2, SW2.2
unnamed: R90.1, R93.2
unnamed: R93.1, TR2.2 (AB)
PE: C1.1, H3.1, H4.1, H5.1, H6.1, H7.1, H8.1, J1.3, J4.3, J9.1, R1.2; also elsewhere on the board

Notes on the sheet:
L-EV2 L-K2
PE N-EV2 N-K2
K2-A1 K2-A2
- KEY-EV2ON GND CP-EV2
L-EV1 L-K1
PE N-EV1 N-K1
K1-A1 K1-A2

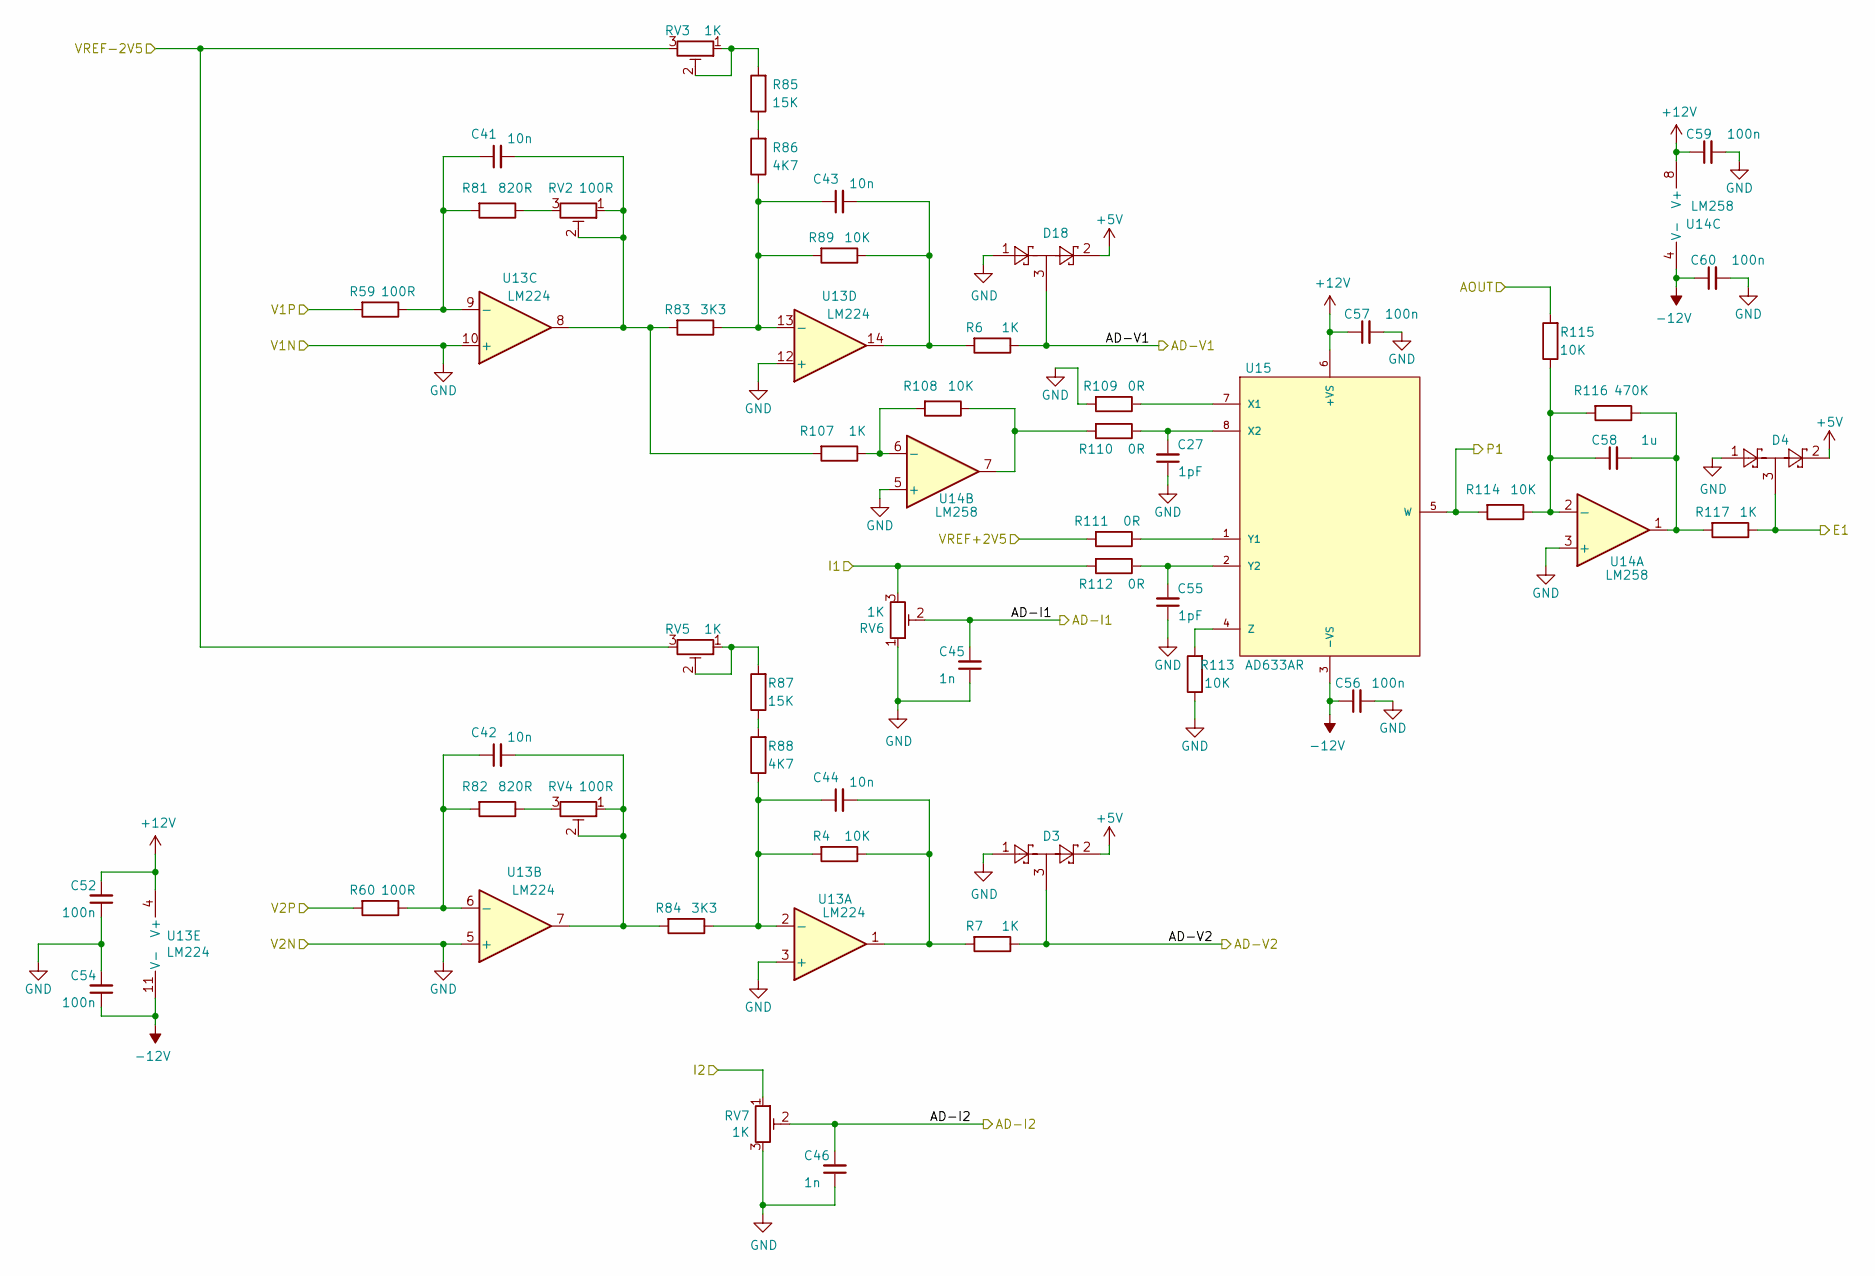
[picture p26: schematic measurement.sch, Electro Vehicle Wallbox Station]

Parts:
C27, C55: 1pF; c-1206-hand-soldering
C41, C42, C43, C44: 10n; c-1206-hand-soldering
C45, C46: 1n; c-1206-hand-soldering
C52, C54, C56, C57, C59, C60: 100n; c-1206-hand-soldering
C58: 1u; c-1206-hand-soldering
D3, D4, D18: BAT54S; sot-23_hand-soldering
R4, R89, R108, R113, R114, R115: 10K; r-1206-hand-soldering
R6, R7, R107, R117: 1K; r-1206-hand-soldering
R59, R60: 100R; r-1206-hand-soldering
R81, R82: 820R; r-1206-hand-soldering
R83, R84: 3K3; r-1206-hand-soldering
R85, R87: 15K; r-1206-hand-soldering
R86, R88: 4K7; r-1206-hand-soldering
R109, R110, R111, R112: 0R; r-1206-hand-soldering
R116: 470K; r-1206-hand-soldering
RV2, RV4: 100R; trimmer-tht-3296
RV3, RV5, RV6, RV7: 1K; trimmer-tht-3296
U13: LM224; soic-14_hand-soldering
U14: LM258; soic-8_hand-soldering
U15: AD633AR; soic-8_hand-soldering

Connections:
+5V: D3.2, D4.2, D18.2; also elsewhere on the board
+12V: C52.2, C57.1, C59.1, U13.4 (V+), U14.8 (V+), U15.6 (+VS); also elsewhere on the board
-12V: C54.1, C56.1, C60.1, U13.11 (V-), U14.4 (V-), U15.3 (-VS); also elsewhere on the board
/AD-E1: D4.3, R117.1; also elsewhere on the board
/AD-I1: C45.2, RV6.2; also elsewhere on the board
/AD-I2: C46.2, RV7.2; also elsewhere on the board
/AD-P1: R114.2, U15.5 (W); also elsewhere on the board
/AD-V1: D18.3, R6.1; also elsewhere on the board
/AD-V2: D3.3, R7.1; also elsewhere on the board
/Measurement/AOUT: R115.2; also elsewhere on the board
/Measurement/I1: R112.2, RV6.3; also elsewhere on the board
/Measurement/I2: RV7.1; also elsewhere on the board
/Measurement/V1P: R59.2; also elsewhere on the board
/Measurement/V2P: R60.2; also elsewhere on the board
/Measurement/VREF+2V5: R111.2; also elsewhere on the board
/Measurement/VREF-2V5: RV3.3, RV5.3; also elsewhere on the board
GND: C27.1, C45.1, C46.1, C52.1, C54.2, C55.1, C56.2, C57.2, C59.2, C60.2, D3.1, D4.1, D18.1, R109.2, R113.1, RV6.1, RV7.3, U13.3 (+), U13.5 (+), U13.10 (+), U13.12 (+), U14.3 (+), U14.5 (+); also elsewhere on the board
unnamed: C27.2, R110.1, U15.8 (X2)
unnamed: C41.1, R59.1, R81.2, U13.9 (-)
unnamed: C41.2, R83.2, R107.2, RV2.1, RV2.2, U13.8
unnamed: C42.1, R60.1, R82.2, U13.6 (-)
unnamed: C42.2, R84.2, RV4.1, RV4.2, U13.7
unnamed: C43.1, R83.1, R86.1, R89.2, U13.13 (-)
unnamed: C43.2, R6.2, R89.1, U13.14
unnamed: C44.1, R4.2, R84.1, R88.1, U13.2 (-)
unnamed: C44.2, R4.1, R7.2, U13.1
unnamed: C55.2, R112.1, U15.2 (Y2)
unnamed: C58.1, R114.1, R115.1, R116.2, U14.2 (-)
unnamed: C58.2, R116.1, R117.2, U14.1
unnamed: R81.1, RV2.3
unnamed: R82.1, RV4.3
unnamed: R85.1, R86.2
unnamed: R85.2, RV3.1, RV3.2
unnamed: R87.1, R88.2
unnamed: R87.2, RV5.1, RV5.2
unnamed: R107.1, R108.2, U14.6 (-)
unnamed: R108.1, R110.2, U14.7
unnamed: R109.1, U15.7 (X1)
unnamed: R111.1, U15.1 (Y1)
unnamed: R113.2, U15.4 (Z)

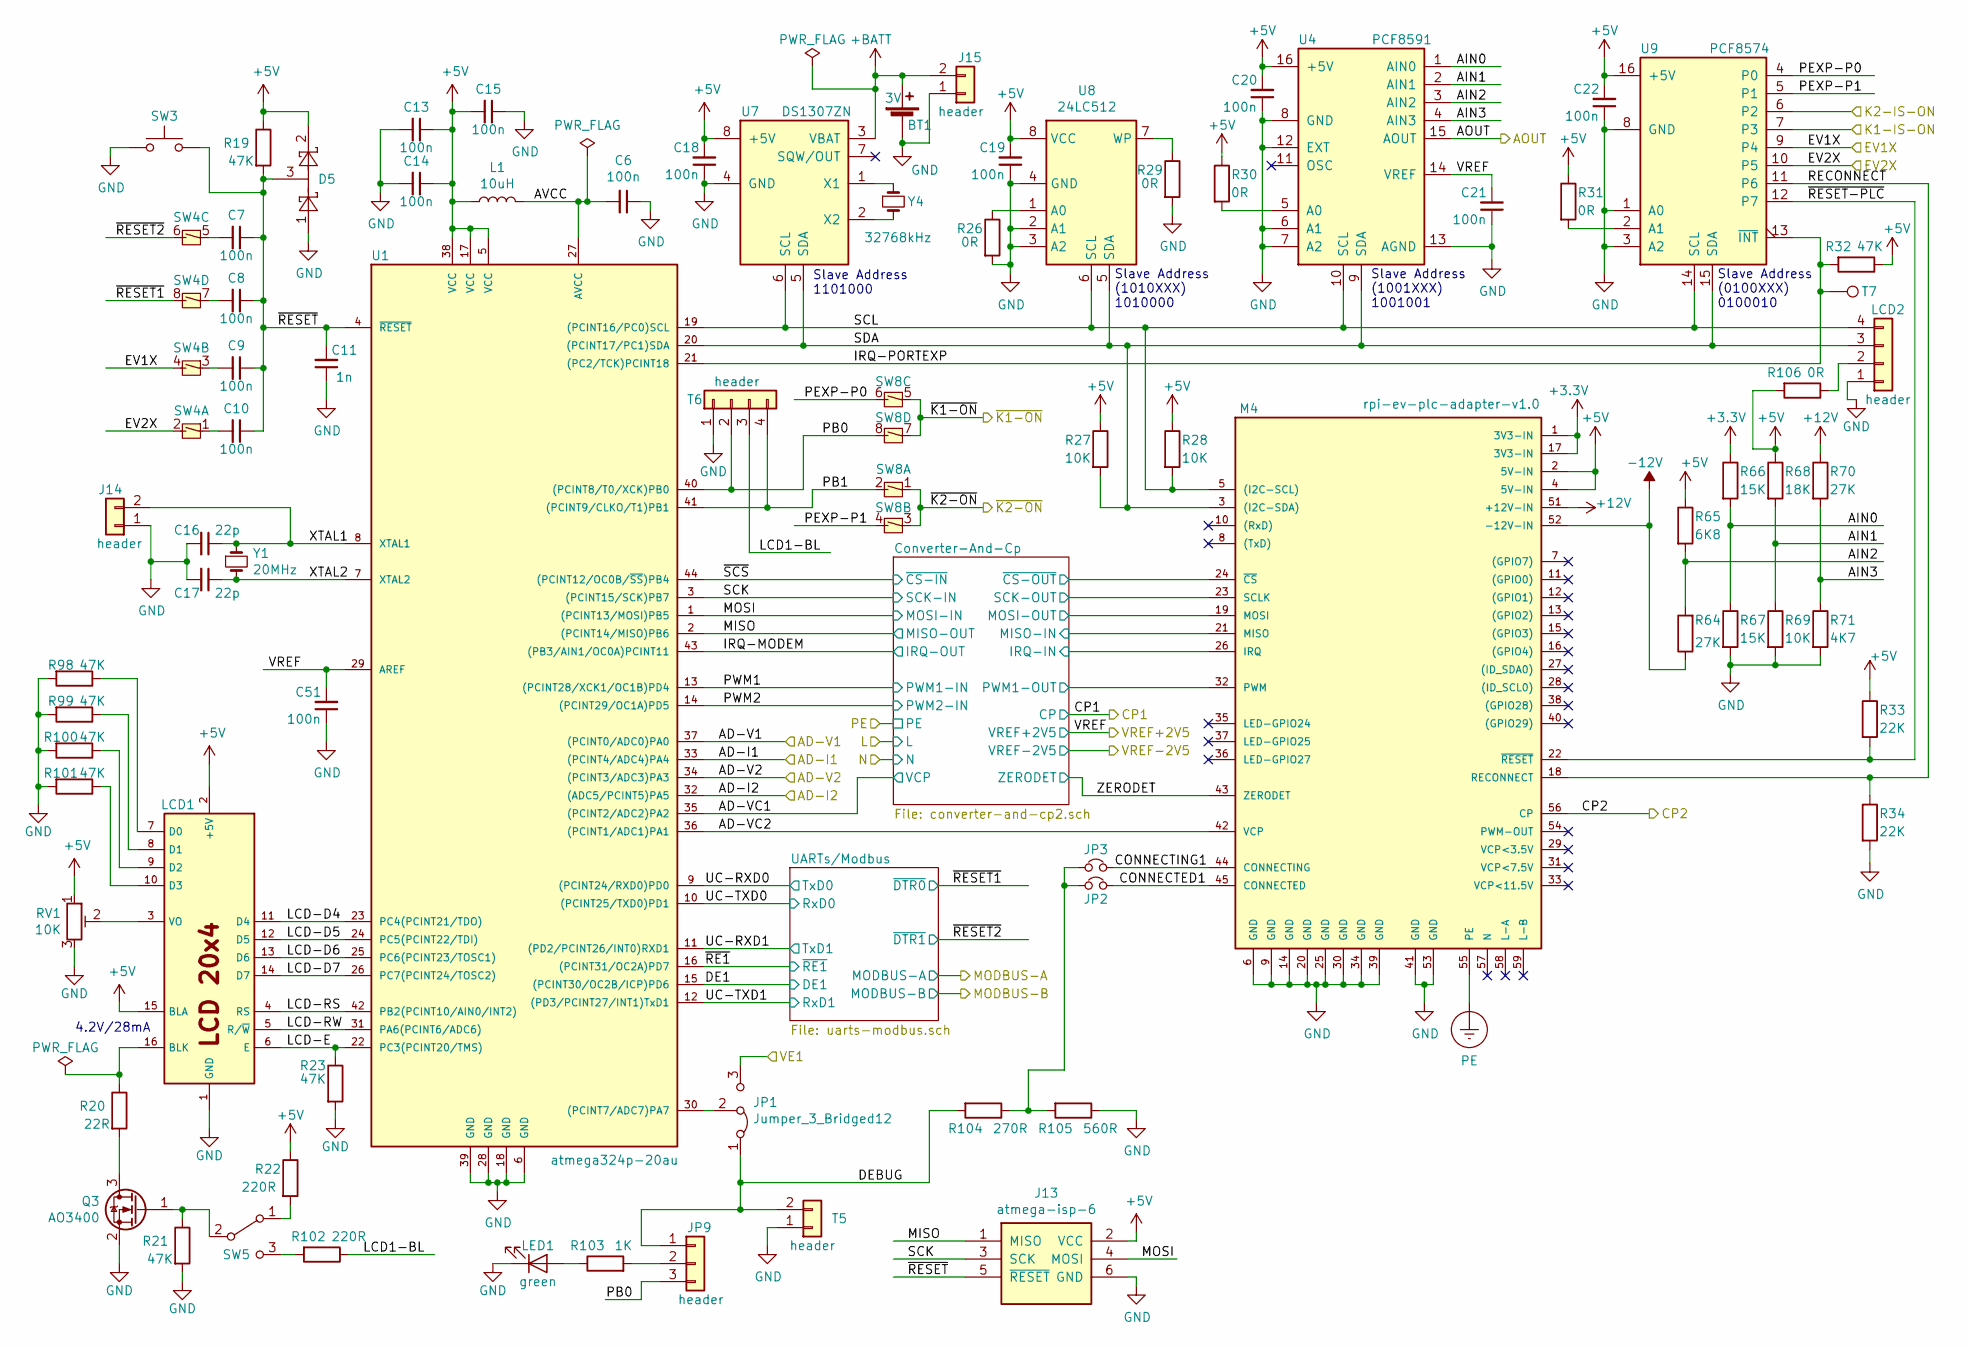
[picture p27: schematic uc.sch, Electro Vehicle Wallbox Station]

Parts:
BT1: 3V; knob-battery-holder-vertical-tht
C6, C7, C8, C9, C10, C13, C14, C15, C18, C19, C20, C21, C22, C51: 100n; c-1206-hand-soldering
C11: 1n; c-1206-hand-soldering
C16, C17: 22p; c-1206-hand-soldering
D5: BAT54S; sot-23_hand-soldering
J13: atmega-isp-6; AVR-ISP-6
J14, J15: header; idc-header-1x02-p2.54mm-vertical
JP1: Jumper_3_Bridged12; idc-header-1x03-p2.54mm-vertical
JP2, JP3: header; idc-header-1x02-p2.54mm-vertical
JP9: header; idc-header-1x03-p2.54mm-vertical
L1: 10uH; L_1206_HandSoldering
LCD1: lcd-4x20-5v-backlight-4bit
LCD2: header; idc-header-1x04-p2.54mm-vertical
LED1: LED; LED_0805_HandSoldering
M4: rpi-ev-plc-adapter-v1.0
Q3: AO3400; sot-23_hand-soldering
R19, R21, R23, R32, R98, R99, R100, R101: 47K; r-1206-hand-soldering
R20: 22R; r-1206-hand-soldering
R22, R102: 220R; r-1206-hand-soldering
R26, R29, R30, R31, R106: 0R; r-1206-hand-soldering
R27, R28, R69: 10K; r-1206-hand-soldering
R33, R34: 22K; r-1206-hand-soldering
R64, R70: 27K; r-1206-hand-soldering
R65: 6K8; r-1206-hand-soldering
R66, R67: 15K; r-1206-hand-soldering
R68: 18K; r-1206-hand-soldering
R71: 4K7; r-1206-hand-soldering
R103: 1K; r-1206-hand-soldering
R104: 270R; r-1206-hand-soldering
R105: 560R; r-1206-hand-soldering
RV1: 10K; trimmer-tht-3296
SW3: SW_Push; push-button-smd-4.5x4.5mm-black
SW4, SW8: dip-switch-4x2pos-smd-1.27mm
SW5: SS-12D00G3; switch_ss-12d00g3
T5: header; idc-header-1x02-p2.54mm-vertical
T6: header; idc-header-1x04-p2.54mm-vertical
T7: TestPoint; Measurement_Point_Round-TH_Small
U1: atmega324p-20au; TQFP-44_10x10mm_Pitch0.8mm
U4: PCF8591; soic-16w_hand-soldering
U7: DS1307ZN; soic-8_hand-soldering
U8: 24LC512; soic-8_hand-soldering
U9: PCF8574; soic-16w_hand-soldering
Y1: 20MHz; hc49s-smd
Y4: 32768kHz; crystal-32.768khz-2x6mm-tht-vertical

Connections:
+5V: C13.1, C14.1, C15.2, C18.2, C19.2, C20.2, C22.2, D5.2, J13.2 (VCC), L1.1, LCD1.2 (+5V), LCD1.15 (BLA), M4.2 (5V-IN), M4.4 (5V-IN), R19.1, R22.1, R27.1, R28.1, R30.1, R31.1, R32.1, R33.1, R65.1, R68.1, R106.2, RV1.1, U1.5 (VCC), U1.17 (VCC), U1.38 (VCC), U4.16 (+5V), U7.8 (+5V), U8.8 (VCC), U9.16 (+5V); also elsewhere on the board
+12V: M4.51 (+12V-IN), R70.1; also elsewhere on the board
+BATT: BT1.1 (+), J15.2, U7.3 (VBAT)
-12V: M4.52 (-12V-IN), R64.1; also elsewhere on the board
/AD-E1: JP1.3 (B); also elsewhere on the board
/AD-I1: U1.33 ((PCINT4/ADC4)PA4); also elsewhere on the board
/AD-I2: U1.32 ((ADC5/PCINT5)PA5); also elsewhere on the board
/AD-V1: U1.37 ((PCINT0/ADC0)PA0); also elsewhere on the board
/AD-V2: U1.34 ((PCINT3/ADC3)PA3); also elsewhere on the board
/CP2: M4.56 (CP); also elsewhere on the board
/EV1X: SW4.4, U9.9 (P4); also elsewhere on the board
/EV2X: SW4.2, U9.10 (P5); also elsewhere on the board
/Measurement/AOUT: U4.15 (AOUT); also elsewhere on the board
/Measurement/VREF+2V5: C21.2, C51.2, U1.29 (AREF), U4.14 (VREF); also elsewhere on the board
/Microcontroller/AD-VC1: U1.35 ((PCINT2/ADC2)PA2); also elsewhere on the board
/Microcontroller/AD-VC2: M4.42 (VCP), U1.36 ((PCINT1/ADC1)PA1)
/Microcontroller/AIN0: R66.2, R67.1, U4.1 (AIN0)
/Microcontroller/AIN1: R68.2, R69.1, U4.2 (AIN1)
/Microcontroller/AIN2: R64.2, R65.2, U4.3 (AIN2)
/Microcontroller/AIN3: R70.2, R71.1, U4.4 (AIN3)
/Microcontroller/AVCC: C6.2, L1.2, U1.27 (AVCC)
/Microcontroller/CONNECTED1: JP2.2, M4.45 (CONNECTED)
/Microcontroller/CONNECTING1: JP3.2, M4.44 (CONNECTING)
/Microcontroller/Converter-And-Cp/IRQ-IN: M4.26 (IRQ); also elsewhere on the board
/Microcontroller/Converter-And-Cp/MISO-IN: M4.21 (MISO); also elsewhere on the board
/Microcontroller/Converter-And-Cp/MOSI-OUT: M4.19 (MOSI); also elsewhere on the board
/Microcontroller/Converter-And-Cp/PWM1-OUT: M4.32 (PWM); also elsewhere on the board
/Microcontroller/Converter-And-Cp/SCK-OUT: M4.23 (SCLK); also elsewhere on the board
/Microcontroller/Converter-And-Cp/~CS-OUT: M4.24 (~CS); also elsewhere on the board
/Microcontroller/DE1: U1.15 ((PCINT30/OC2B/ICP)PD6); also elsewhere on the board
/Microcontroller/DEBUG: JP1.1 (A), JP9.1, R104.2, T5.2
/Microcontroller/IRQ-MODEM: U1.43 ((PB3/AIN1/OC0A)PCINT11); also elsewhere on the board
/Microcontroller/IRQ-PORTEXP: R32.2, T7.1, U1.21 ((PC2/TCK)PCINT18), U9.13 (~INT~)
/Microcontroller/K1-IS-ON: U9.7 (P3); also elsewhere on the board
/Microcontroller/K2-IS-ON: U9.6 (P2); also elsewhere on the board
/Microcontroller/LCD1-BL: R102.1, T6.3
/Microcontroller/LCD-D4: LCD1.11 (D4), U1.23 (PC4(PCINT21/TDO))
/Microcontroller/LCD-D5: LCD1.12 (D5), U1.24 (PC5(PCINT22/TDI))
/Microcontroller/LCD-D6: LCD1.13 (D6), U1.25 (PC6(PCINT23/TOSC1))
/Microcontroller/LCD-D7: LCD1.14 (D7), U1.26 (PC7(PCINT24/TOSC2))
/Microcontroller/LCD-E: LCD1.6 (E), R23.1, U1.22 (PC3(PCINT20/TMS))
/Microcontroller/LCD-RS: LCD1.4 (RS), U1.42 (PB2(PCINT10/AIN0/INT2))
/Microcontroller/LCD-RW: LCD1.5 (R/~W~), U1.31 (PA6(PCINT6/ADC6))
/Microcontroller/MISO: J13.1 (MISO), U1.2 ((PCINT14/MISO)PB6); also elsewhere on the board
/Microcontroller/MOSI: J13.4 (MOSI), U1.1 ((PCINT13/MOSI)PB5); also elsewhere on the board
/Microcontroller/PB0: JP9.3, SW8.8 (4), T6.2, U1.40 ((PCINT8/T0/XCK)PB0)
/Microcontroller/PB1: SW8.2, T6.4, U1.41 ((PCINT9/CLKO/T1)PB1)
/Microcontroller/PEXP-P0: SW8.6 (4), U9.4 (P0)
/Microcontroller/PEXP-P1: SW8.4, U9.5 (P1)
/Microcontroller/PWM1: U1.13 ((PCINT28/XCK1/OC1B)PD4); also elsewhere on the board
/Microcontroller/PWM2: U1.14 ((PCINT29/OC1A)PD5); also elsewhere on the board
/Microcontroller/RECONNECT: M4.18 (RECONNECT), R34.1, U9.11 (P6)
/Microcontroller/SCK: J13.3 (SCK), U1.3 ((PCINT15/SCK)PB7); also elsewhere on the board
/Microcontroller/SCL: LCD2.4, M4.5 ((I2C-SCL)), R28.2, U1.19 ((PCINT16/PC0)SCL), U4.10 (SCL), U7.6 (SCL), U8.6 (SCL), U9.14 (SCL)
/Microcontroller/SDA: LCD2.3, M4.3 ((I2C-SDA)), R27.2, U1.20 ((PCINT17/PC1)SDA), U4.9 (SDA), U7.5 (SDA), U8.5 (SDA), U9.15 (SDA)
/Microcontroller/UC-RXD0: U1.9 ((PCINT24/RXD0)PD0); also elsewhere on the board
/Microcontroller/UC-RXD1: U1.11 ((PD2/PCINT26/INT0)RXD1); also elsewhere on the board
/Microcontroller/UC-TXD0: U1.10 ((PCINT25/TXD0)PD1); also elsewhere on the board
/Microcontroller/UC-TXD1: U1.12 ((PD3/PCINT27/INT1)TxD1); also elsewhere on the board
/Microcontroller/XTAL1: C16.1, J14.2, U1.8 (XTAL1), Y1.1
/Microcontroller/XTAL2: C17.1, U1.7 (XTAL2), Y1.2
/Microcontroller/ZERODET: M4.43 (ZERODET); also elsewhere on the board
/Microcontroller/~K1-ON: SW8.5 (3), SW8.7 (3); also elsewhere on the board
/Microcontroller/~K2-ON: SW8.1, SW8.3; also elsewhere on the board
/Microcontroller/~RE1: U1.16 ((PCINT31/OC2A)PD7); also elsewhere on the board
/Microcontroller/~RESET: C7.1, C8.1, C9.1, C10.1, C11.2, D5.3, J13.5 (~RESET~), R19.2, SW3.2, U1.4 (~RESET)
/Microcontroller/~RESET1: SW4.8 (4); also elsewhere on the board
/Microcontroller/~RESET2: SW4.6 (4); also elsewhere on the board
/Microcontroller/~RESET-PLC: M4.22 (~RESET), R33.2, U9.12 (P7)
/Microcontroller/~SCS: U1.44 ((PCINT12/OC0B/~SS~)PB4); also elsewhere on the board
GND: BT1.2 (-), C6.1, C11.1, C13.2, C14.2, C15.1, C16.2, C17.2, C18.1, C19.1, C20.1, C21.1, C22.1, C51.1, D5.1, J13.6 (GND), J14.1, J15.1, LCD1.1 (GND), LCD2.1, LED1.1 (K), M4.6 (GND), M4.9 (GND), M4.14 (GND), M4.20 (GND), M4.25 (GND), M4.30 (GND), M4.34 (GND), M4.39 (GND), M4.41 (GND), M4.53 (GND), Q3.2 (S), R21.2, R23.2, R26.2, R29.2, R34.2, R67.2, R69.2, R71.2, R98.2, R99.2, R100.2, R101.2, R105.1, RV1.3, SW3.1, T5.1, T6.1, U1.6 (GND), U1.18 (GND), U1.28 (GND), U1.39 (GND), U4.6 (A1), U4.7 (A2), U4.8 (GND), U4.12 (EXT), U4.13 (AGND), U7.4 (GND), U8.2 (A1), U8.3 (A2), U8.4 (GND), U9.1 (A0), U9.3 (A2), U9.8 (GND); also elsewhere on the board
unnamed: C7.2, SW4.5 (3)
unnamed: C8.2, SW4.7 (3)
unnamed: C9.2, SW4.3
unnamed: C10.2, SW4.1
unnamed: JP1.2 (C), U1.30 ((PCINT7/ADC7)PA7)
unnamed: JP2.1, JP3.1, R104.1, R105.2
unnamed: JP9.2, R103.2
unnamed: LCD1.3 (VO), RV1.2
unnamed: LCD1.7 (D0), R98.1
unnamed: LCD1.8 (D1), R99.1
unnamed: LCD1.9 (D2), R100.1
unnamed: LCD1.10 (D3), R101.1
unnamed: LCD1.16 (BLK), R20.1
unnamed: LCD2.2, R106.1
unnamed: LED1.2 (A), R103.1
unnamed: Q3.1 (G), R21.1, SW5.2 (B)
unnamed: Q3.3 (D), R20.2
unnamed: R22.2, SW5.1 (A)
unnamed: R26.1, U8.1 (A0)
unnamed: R29.1, U8.7 (WP)
unnamed: R30.2, U4.5 (A0)
unnamed: R31.2, U9.2 (A1)
unnamed: R102.2, SW5.3 (C)
unnamed: U7.1 (X1), Y4.1
unnamed: U7.2 (X2), Y4.2
PE: M4.55 (PE); also elsewhere on the board

Notes on the sheet:
4.2V/28mA
Slave Address 1101000
Slave Address (1001XXX) 1001001
Slave Address (1010XXX) 1010000
Slave Address (0100XXX) 0100010

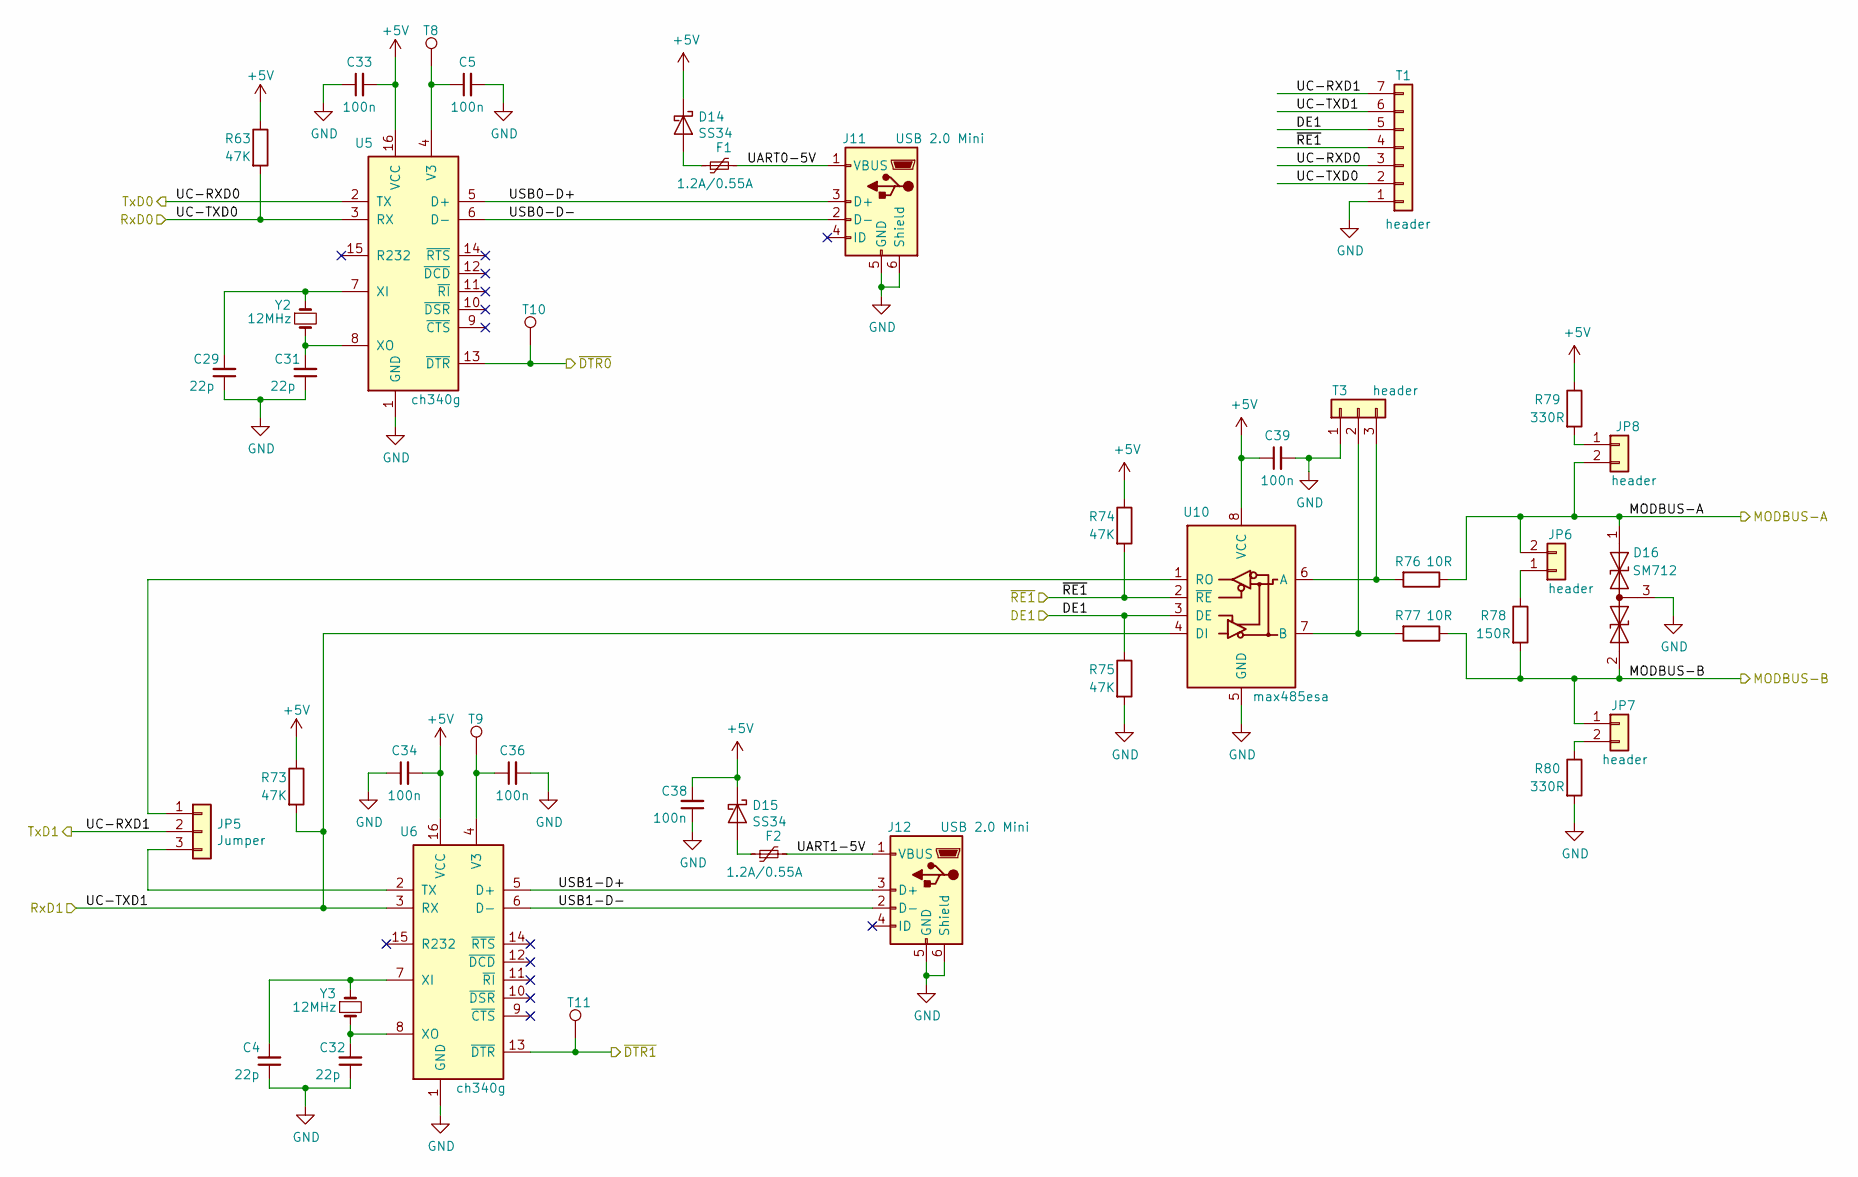
[picture p28: schematic uarts-modbus.sch, Electro Vehicle Wallbox Station 1]

Parts:
C4, C29, C31, C32: 22p; c-1206-hand-soldering
C5, C33, C34, C36, C38, C39: 100n; c-1206-hand-soldering
D14, D15: SS34; sma_hand-soldering
D16: SM712; sot-23_hand-soldering
F1, F2: MF-SMDF050-2; mf-smdf
J11, J12: USB 2.0 Mini; usb-mini-tht
JP5: Jumper; idc-header-1x03-p2.54mm-vertical
JP6, JP7, JP8: header; idc-header-1x02-p2.54mm-vertical
R63, R73, R74, R75: 47K; r-1206-hand-soldering
R76, R77: 10R; r-1206-hand-soldering
R78: 150R; r-1206-hand-soldering
R79, R80: 330R; r-1206-hand-soldering
T1: header; idc-header-1x07-p2.54mm-vertical
T3: header; idc-header-1x03-p2.54mm-vertical
T8, T9, T10, T11: TestPoint; SolderWirePad_single_0-8mmDrill
U5, U6: ch340g; soic-16_hand-soldering
U10: max485esa; soic-8_hand-soldering
Y2, Y3: 12MHz; Oscillator-SMD-M49S

Connections:
+5V: C33.2, C34.2, C38.2, C39.1, D14.1 (K), D15.1 (K), R63.1, R73.1, R74.1, R79.1, U5.16 (VCC), U6.16 (VCC), U10.8 (VCC); also elsewhere on the board
/MODBUS-A: D16.1 (A1), JP6.2, JP8.2, R76.1; also elsewhere on the board
/MODBUS-B: D16.2 (A2), JP7.1, R77.1, R78.2; also elsewhere on the board
/Microcontroller/DE1: R75.1, T1.5, U10.3 (DE); also elsewhere on the board
/Microcontroller/UARTs/Modbus/UART0-5V: F1.2, J11.1 (VBUS)
/Microcontroller/UARTs/Modbus/UART1-5V: F2.2, J12.1 (VBUS)
/Microcontroller/UARTs/Modbus/USB0-D+: J11.3 (D+), U5.5 (D+)
/Microcontroller/UARTs/Modbus/USB0-D-: J11.2 (D-), U5.6 (D-)
/Microcontroller/UARTs/Modbus/USB1-D+: J12.3 (D+), U6.5 (D+)
/Microcontroller/UARTs/Modbus/USB1-D-: J12.2 (D-), U6.6 (D-)
/Microcontroller/UC-RXD0: T1.3, U5.2 (TX); also elsewhere on the board
/Microcontroller/UC-RXD1: JP5.2, T1.7; also elsewhere on the board
/Microcontroller/UC-TXD0: R63.2, T1.2, U5.3 (RX); also elsewhere on the board
/Microcontroller/UC-TXD1: R73.2, T1.6, U6.3 (RX), U10.4 (DI); also elsewhere on the board
/Microcontroller/~RE1: R74.2, T1.4, U10.2 (~RE); also elsewhere on the board
/Microcontroller/~RESET1: T10.1, U5.13 (~DTR~); also elsewhere on the board
/Microcontroller/~RESET2: T11.1, U6.13 (~DTR~); also elsewhere on the board
GND: C4.1, C5.2, C29.1, C31.1, C32.1, C33.1, C34.1, C36.2, C38.1, C39.2, D16.3 (common), J11.5 (GND), J11.6 (Shield), J12.5 (GND), J12.6 (Shield), R75.2, R80.2, T1.1, T3.1, U5.1 (GND), U6.1 (GND), U10.5 (GND); also elsewhere on the board
unnamed: C4.2, U6.7 (XI), Y3.1
unnamed: C5.1, T8.1, U5.4 (V3)
unnamed: C29.2, U5.7 (XI), Y2.1
unnamed: C31.2, U5.8 (XO), Y2.2
unnamed: C32.2, U6.8 (XO), Y3.2
unnamed: C36.1, T9.1, U6.4 (V3)
unnamed: D14.2 (A), F1.1
unnamed: D15.2 (A), F2.1
unnamed: JP5.1, U10.1 (RO)
unnamed: JP5.3, U6.2 (TX)
unnamed: JP6.1, R78.1
unnamed: JP7.2, R80.1
unnamed: JP8.1, R79.2
unnamed: R76.2, T3.3, U10.6 (A)
unnamed: R77.2, T3.2, U10.7 (B)
