greenenergyprojects/electro-vehicle-wallbox-station/evws1/kicad/evws1.kicad_pcb

## KiCad design evws1/kicad/evws1.kicad_pcb (continued)

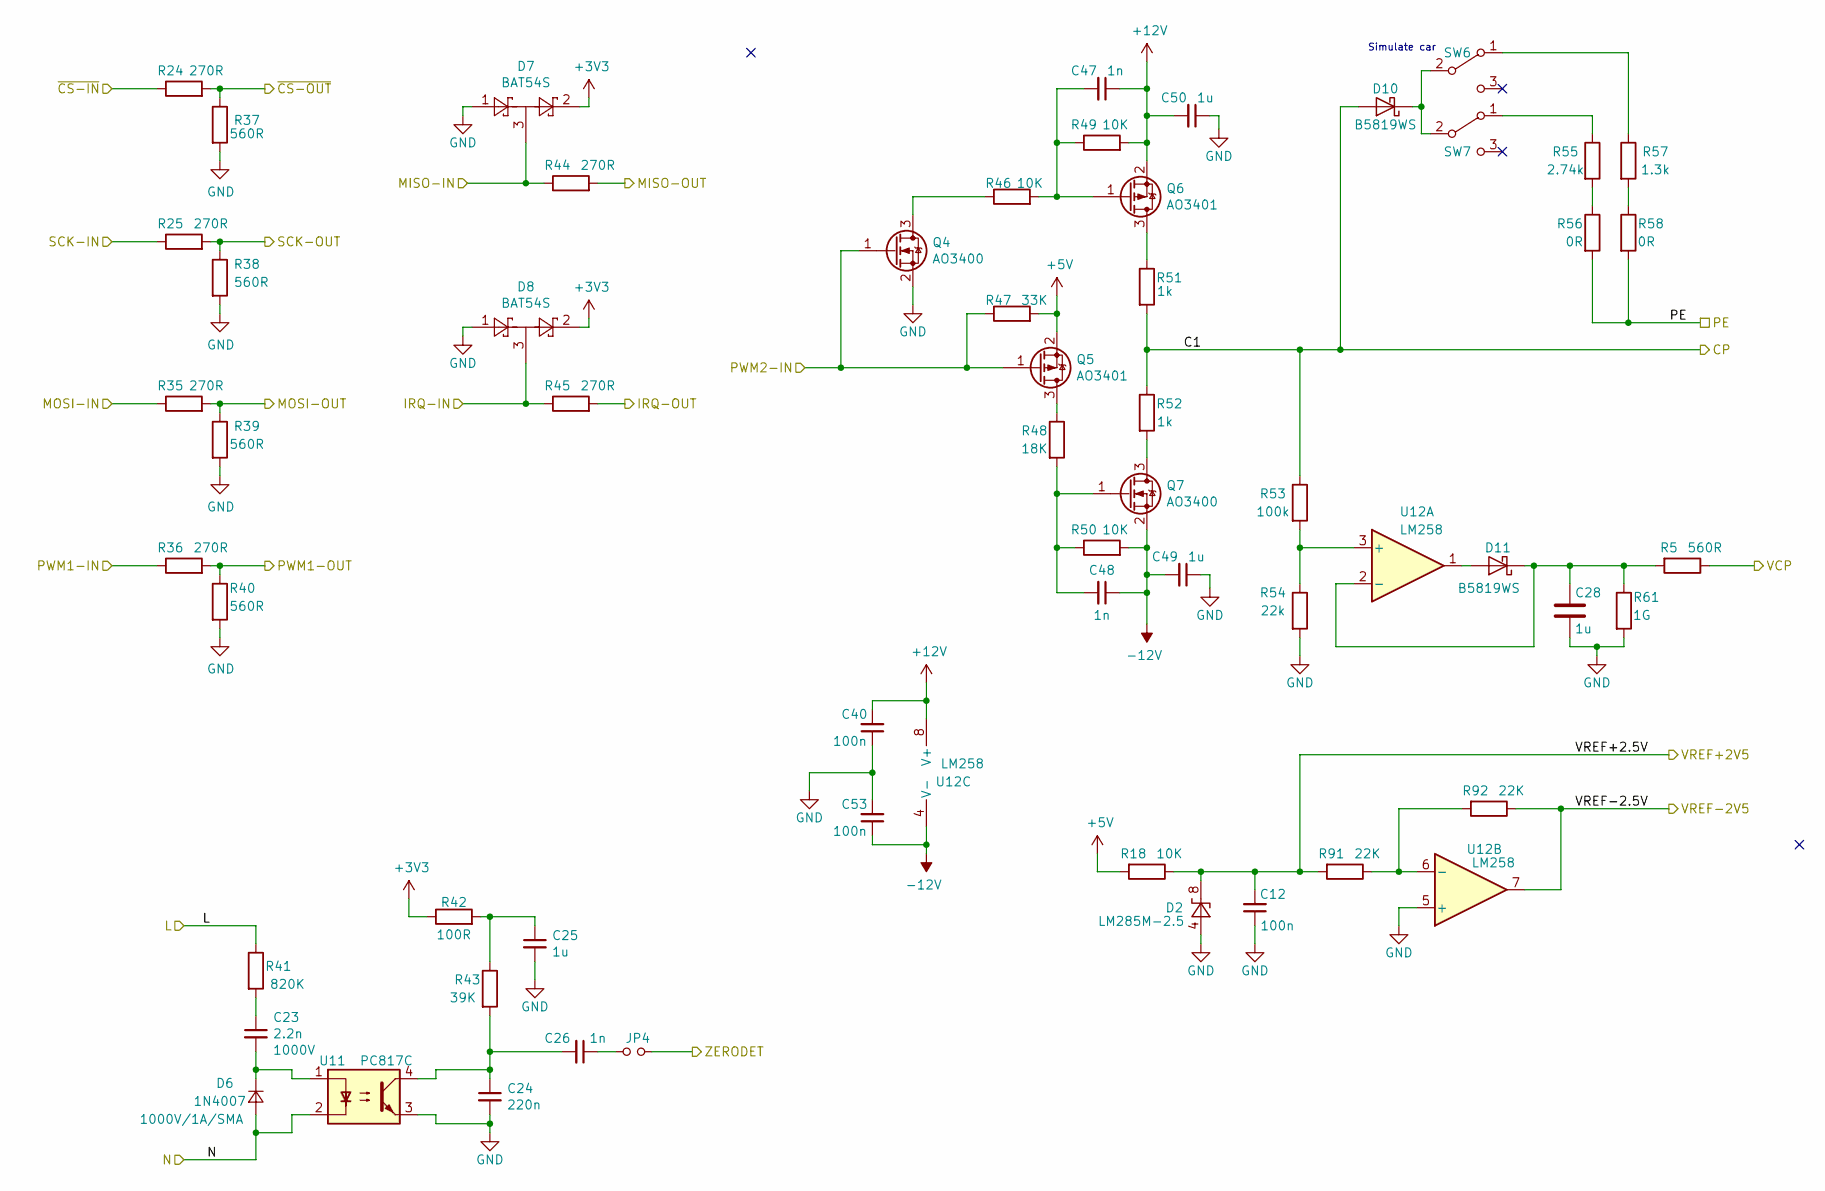
[picture p29: schematic converter-and-cp2.sch, Electro Vehicle Wallbox Station]

Parts:
C12, C40, C53: 100n; c-1206-hand-soldering
C23: 2.2n; c-1206-hand-soldering
C24: 220n; c-1206-hand-soldering
C25, C28, C49, C50: 1u; c-1206-hand-soldering
C26, C47, C48: 1n; c-1206-hand-soldering
D2: LM285M-2.5; SOIC-8_3.9x4.9mm_Pitch1.27mm_Handsolded
D6: 1N4007; sma_hand-soldering
D7, D8: BAT54S; sot-23_hand-soldering
D10, D11: B5819WS; sod-323_hand-soldering
JP4: Jumper_NO_Small; idc-header-1x02-p2.54mm-vertical
Q4, Q7: AO3400; sot-23_hand-soldering
Q5, Q6: AO3401; sot-23_hand-soldering
R5, R37, R38, R39, R40: 560R; r-1206-hand-soldering
R18, R46, R49, R50: 10K; r-1206-hand-soldering
R24, R25, R35, R36, R44, R45: 270R; r-1206-hand-soldering
R41: 820K; r-1206-hand-soldering
R42: 100R; r-1206-hand-soldering
R43: 39K; r-1206-hand-soldering
R47: 33K; r-1206-hand-soldering
R48: 18K; r-1206-hand-soldering
R51, R52: 1k; r-1206-hand-soldering
R53: 100k; r-1206-hand-soldering
R54: 22k; r-1206-hand-soldering
R55: 2.74k; r-1206-hand-soldering
R56, R58: 0R; r-1206-hand-soldering
R57: 1.3k; r-1206-hand-soldering
R61: 1G; r-1206-hand-soldering
R91, R92: 22K; r-1206-hand-soldering
SW6, SW7: SS-12D00G3; switch_ss-12d00g3
U11: PC817C; sop-4-pc817
U12: LM258; soic-8_hand-soldering

Connections:
230V-L: R41.1; also elsewhere on the board
230V-N: D6.2 (A), U11.2; also elsewhere on the board
+5V: Q5.2 (S), R18.2, R47.2; also elsewhere on the board
+12V: C40.2, C47.1, C50.2, Q6.2 (S), R49.2, U12.8 (V+); also elsewhere on the board
-12V: C48.1, C49.2, C53.1, Q7.2 (S), R50.2, U12.4 (V-); also elsewhere on the board
/CP1: D10.2 (A), R51.2, R52.1, R53.1; also elsewhere on the board
/Measurement/VREF+2V5: C12.2, D2.8 (K), R18.1, R91.2; also elsewhere on the board
/Measurement/VREF-2V5: R92.1, U12.7; also elsewhere on the board
/Microcontroller/AD-VC1: R5.1; also elsewhere on the board
/Microcontroller/Converter-And-Cp/IRQ-IN: D8.3, R45.1; also elsewhere on the board
/Microcontroller/Converter-And-Cp/MISO-IN: D7.3, R44.1; also elsewhere on the board
/Microcontroller/Converter-And-Cp/MOSI-OUT: R35.2, R39.1; also elsewhere on the board
/Microcontroller/Converter-And-Cp/PWM1-OUT: R36.2, R40.1; also elsewhere on the board
/Microcontroller/Converter-And-Cp/SCK-OUT: R25.2, R38.1; also elsewhere on the board
/Microcontroller/Converter-And-Cp/~CS-OUT: R24.2, R37.1; also elsewhere on the board
/Microcontroller/IRQ-MODEM: R45.2; also elsewhere on the board
/Microcontroller/MISO: R44.2; also elsewhere on the board
/Microcontroller/MOSI: R35.1; also elsewhere on the board
/Microcontroller/PWM1: R36.1; also elsewhere on the board
/Microcontroller/PWM2: Q4.1 (G), Q5.1 (G), R47.1; also elsewhere on the board
/Microcontroller/SCK: R25.1; also elsewhere on the board
/Microcontroller/ZERODET: JP4.2; also elsewhere on the board
/Microcontroller/~SCS: R24.1; also elsewhere on the board
GND: C12.1, C24.2, C25.2, C28.2, C40.1, C49.1, C50.1, C53.2, D2.4 (A), D7.1, D8.1, Q4.2 (S), R37.2, R38.2, R39.2, R40.2, R54.2, R61.2, U11.3, U12.5 (+); also elsewhere on the board
unnamed: C23.1, R41.2
unnamed: C23.2, D6.1 (K), U11.1
unnamed: C24.1, C26.2, R43.2, U11.4
unnamed: C25.1, R42.2, R43.1
unnamed: C26.1, JP4.1
unnamed: C28.1, D11.1 (K), R5.2, R61.1, U12.2 (-)
unnamed: C47.2, Q6.1 (G), R46.2, R49.1
unnamed: C48.2, Q7.1 (G), R48.2, R50.1
unnamed: D10.1 (K), SW6.2 (B), SW7.2 (B)
unnamed: D11.2 (A), U12.1
unnamed: Q4.3 (D), R46.1
unnamed: Q5.3 (D), R48.1
unnamed: Q6.3 (D), R51.1
unnamed: Q7.3 (D), R52.2
unnamed: R53.2, R54.1, U12.3 (+)
unnamed: R55.1, SW7.1 (A)
unnamed: R55.2, R56.1
unnamed: R57.1, SW6.1 (A)
unnamed: R57.2, R58.1
unnamed: R91.1, R92.2, U12.6 (-)
PE: R56.2, R58.2; also elsewhere on the board

Notes on the sheet:
Simulate car

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
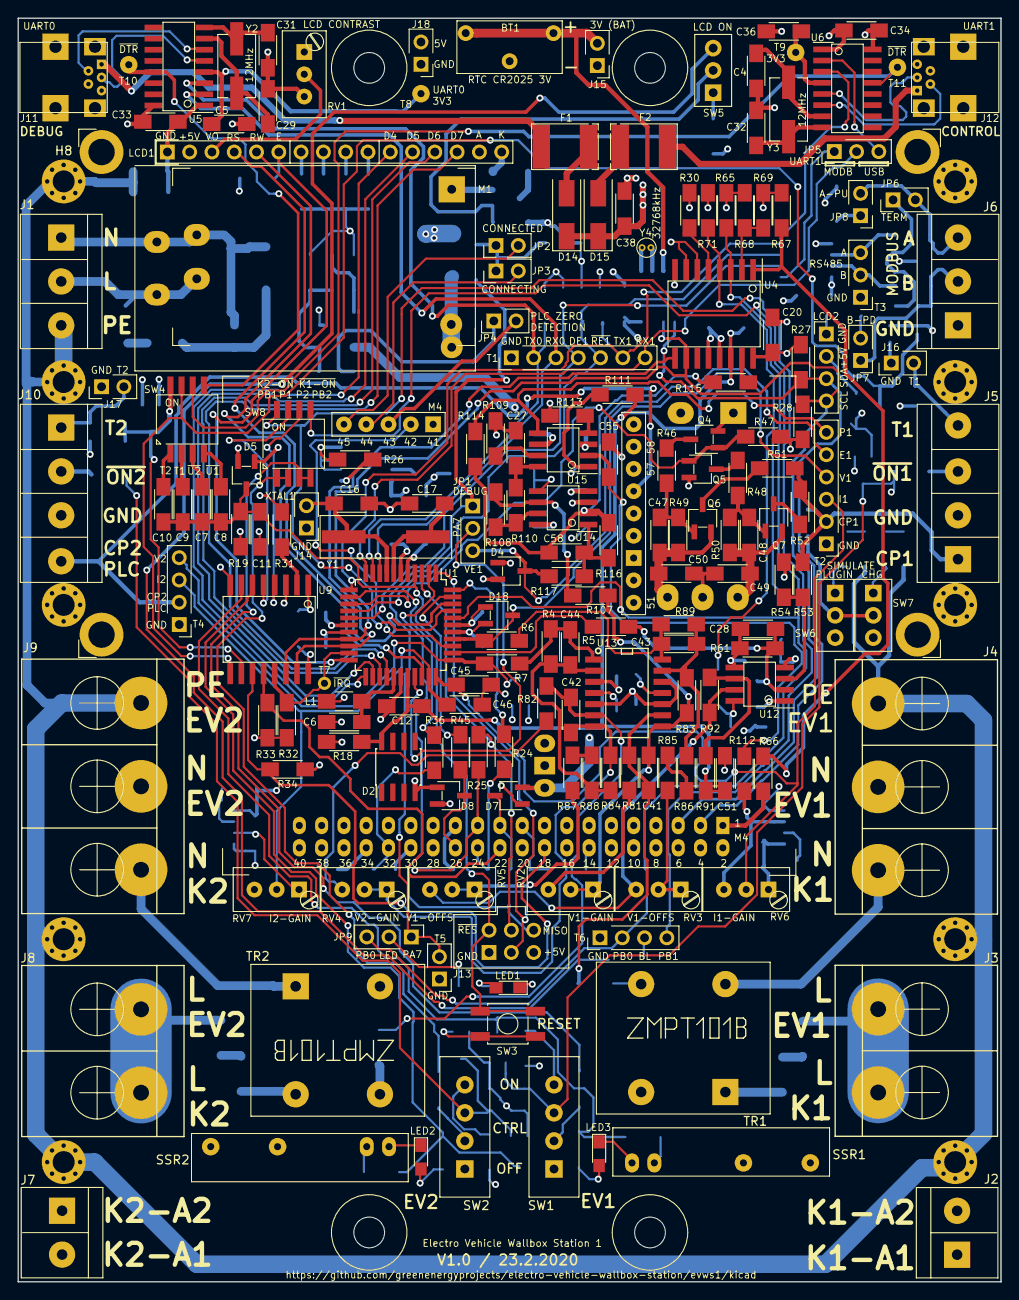
[picture p30: board evws1.kicad_pcb from above]

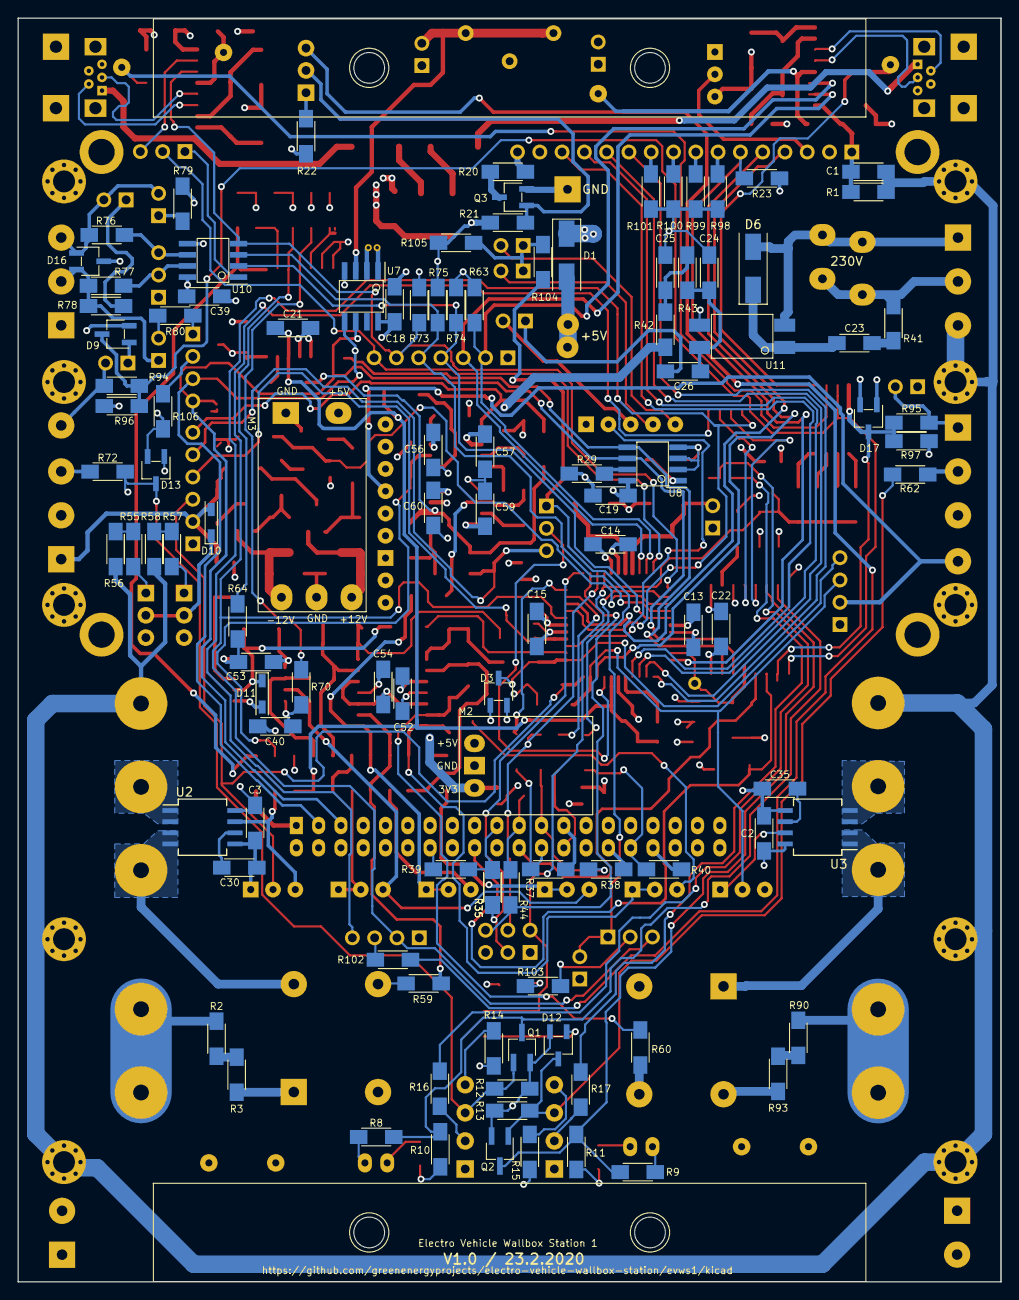
[picture p31: board evws1.kicad_pcb from below]

Board: 4 copper layers, 112.0 x 144.0 mm, 303 parts (110 on the bottom side), 204 nets.

Other parts of the board:
R35#2: 270R; r-1206-hand-soldering

Their connections:
/Microcontroller/Converter-And-Cp/MOSI-OUT: R35#2.2; also elsewhere on the board
/Microcontroller/MOSI: R35#2.1; also elsewhere on the board
