greenenergyprojects/electro-vehicle-wallbox-station/(commit log)

2020-01-31 Schematic completed, no DRC errors left
    [evws1.kicad_pcb, evws1.sch, measurement.sch, uarts-modbus.sch, uc.sch]
2020-02-03 schematic finished
    [_saved_converter-and-cp2.sch, _saved_uarts-modbus.sch, _saved_uc.sch, evws1.kicad_pcb, evws1.sch, measurement.sch]
2020-02-17 schematic finished, placement finished
    [converter-and-cp2.sch, evws1.kicad_pcb, evws1.sch, measurement.sch, uc.sch]
2020-02-21 first routing finished, clean DRC
    [evws1.kicad_pcb, uarts-modbus.sch]
2020-02-23 V1.0 Design finished
    [converter-and-cp2.sch, evws1.kicad_pcb, evws1.sch, measurement.sch, uarts-modbus.sch, uc.sch]
2020-02-23 Renaming kicad/evws1 -> evws1/kicad
    [control-pilot2.sch, converter-and-cp2.sch, evws1.kicad_pcb, evws1.sch, measurement.sch, uarts-modbus.sch, uc.sch, zerodet.sch]
2020-02-23 fixing project problems, cause by renaming directory
    [control-pilot2.sch, converter-and-cp2.sch, evws1.kicad_pcb, evws1.sch, measurement.sch, uarts-modbus.sch, uc.sch, zerodet.sch]
2020-02-23 Tapeout V1.0
    [evws1.kicad_pcb, evws1_bom.ods]
